TUM-E21-ThinFilms/BigChamber/Relay/Schematics/README.md

# BigChamber-RelayDriver
Electronic schematic of a relay driver, supporting 24 relays @ 10A. The relays are galvanically isolated using optocouplers. The relays are driven using a standard I2C interface (via e.g. Arduino/STM32 BluePill) and shift registers

# Pictures
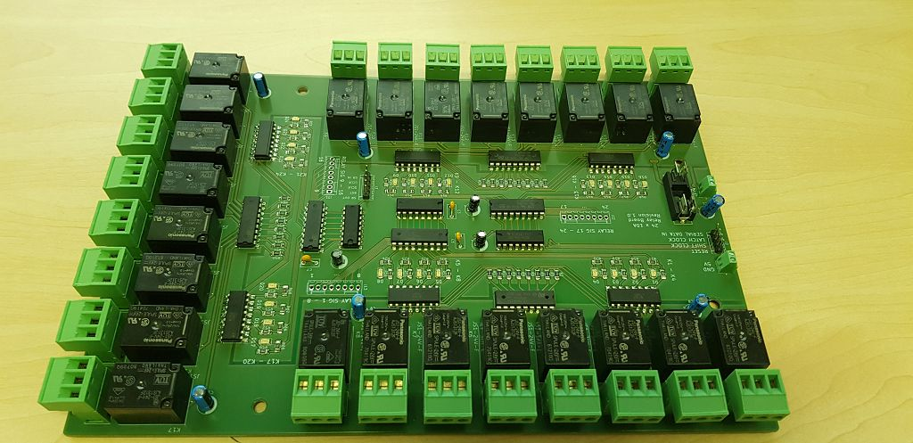
[picture p1: Relay/Schematics/06_Pictures/k-20190725_110336.jpg]
Relay driver overview

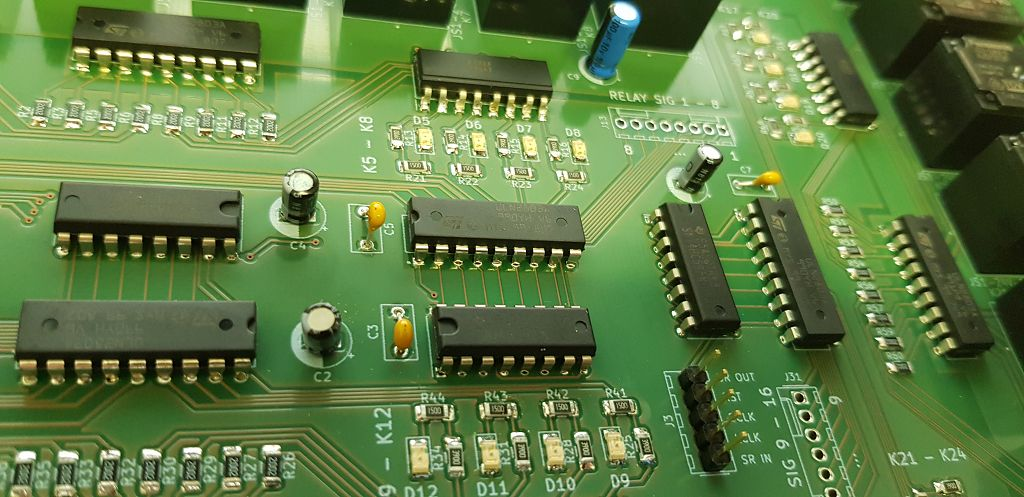
[picture p2: Relay/Schematics/06_Pictures/k-20190725_110252.jpg]
Relay driver closeup view


[pic1]: https://github.com/TUM-E21-ThinFilms/BigChamber/blob/master/Relay/Schematics/06_Pictures/k-20190725_110252.jpg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
[pic2]: https://github.com/TUM-E21-ThinFilms/BigChamber/blob/master/Relay/Schematics/06_Pictures/k-20190725_110336.jpg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
