TUM-E21-ThinFilms/BigChamber/TemperatureSensor/Documentation/TemperatureSensor.odt

Temperature Sensor

Parts

Raspberry Pi (https://go.pimylifeup.com/l8KF94/amazon/raspberrypi)

Micro SD Card

DS18B20 Temperature Sensor (https://go.pimylifeup.com/tYbBFb/amazon/DS18B20)s

4.7 k (https://go.pimylifeup.com/kZ1Fwt/amazon/4k7resistors)Ω (https://go.pimylifeup.com/kZ1Fwt/amazon/4k7resistors) Resistor (https://go.pimylifeup.com/kZ1Fwt/amazon/4k7resistors)

Breadboard (https://go.pimylifeup.com/LSWdzn/amazon/breadboard)

Breadboard Wire (https://go.pimylifeup.com/MxKKAK/amazon/breadboardwire)

Jumper Cables

Protocol

DS18B20 sensors communicates with the “One-Wire” communication protocol, means that only one wire is used to transmit the temperature readings to the micro-controller and two other wires are required for operation :

V CC (Red Wire)

Ground (Black Wire)

Data Wire (Yellow Wire)

A 4.7 kΩ pull-up resistor is placed on the breadboard between the V CC(Red) and, the Data Wire (Yellow).

Then,using jumper cables, the RPi pins are connected as below:

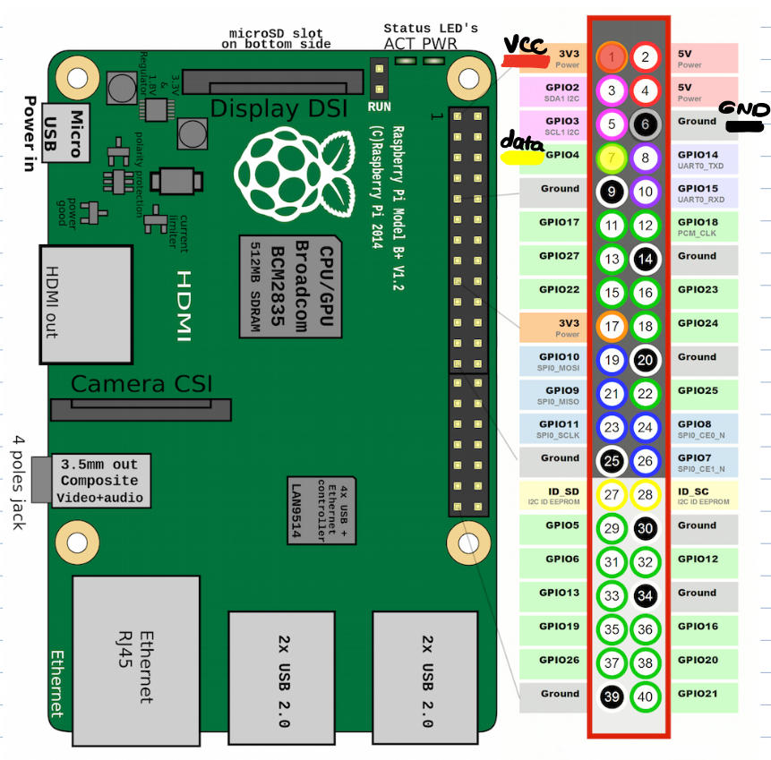
[picture p3: figure]

V CC ==> Pin 1

Ground ==> Pin 6

Data Wire ==> Pin 7

The rest of the sensors can be parallelly connected to the first sensor and the same GPIO pin of Rpi. Because each sensor has a specific wire address to communicate with RPi.

Rpi is already set-up as follows:

User: Pi

Password: raspberryE21

The $ dtoverlay=w1-gpio was added to the last line of the boot config file $ sudo nano /boot/config.txt. After saving and exciting nano, Rpi rebooted with $ sudo reboot. Once the Raspberry Pi has booted back up, mod probe need to run so that correct modules can be loaded:

$ sudo modprobe w1-gpio

$ sudo modprobe w1-therm

So, after connecting the sensors as mentioned, we can move forward to run the codes. Directory for codes are :

/home/pi/Desktop/Documents

Temp-Script.py is the German code file, TemperatureMeasurement.py is the English one and, finally, the MultipleSensors.py contains codes for of all 5 sensors.

In case of any error regarding the wire addresses, it can be solved by opening a terminal and entering this command:

$ ls -l /sys/bus/w1/devices/

We can see the list of wire addresses for all connected sensors. Then the number appeared as 28-XXXX should be replaced in the respective code line of the sensor.

For the sensors we used, the addresses for each are labeled on the cable and you can find it in this table, as well:

Sensor.1 | 28-03049779dae9
Sensor.2 | 28-03049779da5b
Sensor.3 | 28-031197796d7c
Sensor.4 | 28-031197796aa1
Sensor.5 | 28-030297792649
