TUM-E21-ThinFilms/BigChamber/Relay/Schematics/04_Warenkorb/Warenkorb-zweite-Bestellung.pdf

06105/401-234 | http://de.rs-
| online.com

06105/401-100

RS Components GmbH
Hessenring 13b
64546 Mörfelden-Walldorf

Ihr Warenkorb auf de.rs-online.com

Diese Bestellung wurde noch nicht abgeschickt aber automatisch für Ihren nächsten Besuch auf RS Online gespeichert.

Beschreibung | Menge | Preis/ Einheiten

## Warenwert

Panasonic Monostabiles Relais Printrelais,
24Vdc Spule, 1-poliger Wechsler 10 A 6525381
Panasonic
JS1-24V-F
RoHS-Status - Kompatibel

25

### 25 Lieferbar am folgenden

Werktag (Mo-Fr) bei
Bestelleingang werktags bis 22 Uhr.

1,28 €
Stück

32,00 €

NPN Darlington-Paar ULN2803A 50 V 500 mA HFE:1000, PDIP 18-Pin Gemeinsamer Impulsgeber
7141167
STMicroelectronics
ULN2803A
RoHS-Status - Kompatibel

5

### 5 Lieferbar am folgenden

Werktag (Mo-Fr) bei
Bestelleingang werktags bis 22 Uhr.

1,038 €
Stück (In
einer VPE à 5)

5,19 €

Lite-On 4 Optokoppler, 50 mA DC Input Transistor Output, 5 kV eff 50 % SMD, PDIP 16-Pin
6912246
Lite-On
LTV-847S
RoHS-Status - Kompatibel

6

6 Voraussichtlich ab 14.10.2019 verfügbar.

0,675 €
Stück (In
einer VPE à 2)

4,05 €

KEMET, Goldmax 300 THT MLCC, Vielschicht Keramikkondensator X7R, 100nF ±10% / 50Vdc, 125°C, Gehäuse Radial
5381310
KEMET
C320C104K5R5TA
RoHS-Status - Kompatibel

5

### 5 Lieferbar am folgenden

Werktag (Mo-Fr) bei
Bestelleingang werktags bis 22 Uhr.

0,186 €
Stück (In
einer VPE à 5)

0,93 €

Vishay 038 RSU, THT Alu Kondensator, Elko 100μF ±20%, 10Vdc, Ø 5mm, –40 → +85 °C 6841872
Vishay
MAL203854101E3
RoHS-Status - Kompatibel

5

### 5 lieferbar innerhalb von 1

Werktag(en) (Mo-Fr).

0,048 €
Stück (In
einer VPE à 5)

0,24 €

Kingbright 1206 SMD LED grün 2,2 V, 120° rechteckige Linse 3216 / 1206
4663908
Kingbright
KP-3216SGC
RoHS-Status - Kompatibel

40

### 40 Lieferbar am folgenden

Werktag (Mo-Fr) bei
Bestelleingang werktags bis 22 Uhr.

0,167 €
Stück (In einer
VPE à 40)

6,68 €

06105/401-234 | http://de.rs-
| online.com

06105/401-100

Nichicon SR, THT Alu Kondensator, Elko 1μF ±20%, 50Vdc, Ø 4mm, –40 → +85 °C 4759009
Nichicon
USR1H010MDD
RoHS-Status - Kompatibel

5

### 5 Lieferbar am folgenden

Werktag (Mo-Fr) bei
Bestelleingang werktags bis 22 Uhr.

0,148 €
Stück (In
einer VPE à 5)

0,74 €

Molex KK 254 Female 2.54mm, 8-polig / 1-reihig Gerade, Kabelmontage
6795417
Molex
22-01-3087
RoHS-Status - Kompatibel

10

### 10 Lieferbar am folgenden

Werktag (Mo-Fr) bei
Bestelleingang werktags bis 22 Uhr.

0,275 €
Stück (In einer
VPE à 10)

2,75 €

Molex KK 254 Leiterplatten-Stiftleiste gerade, 8-polig / 1-reihig, Raster 2.54mm, Lötanschluss, 4A
6795606
Molex
22-23-2081
RoHS-Status - Kompatibel

10

### 10 lieferbar innerhalb von 1

Werktag(en) (Mo-Fr).

0,392 €
Stück (In einer
VPE à 10)

3,92 €

Molex KK 254 Female 2.54mm, 4-polig / 1-reihig Gerade, Kabelmontage
6795388
Molex
22-01-3047
RoHS-Status - Kompatibel

10

### 10 Lieferbar am folgenden

Werktag (Mo-Fr) bei
Bestelleingang werktags bis 22 Uhr.

0,134 €
Stück (In einer
VPE à 10)

1,34 €

Molex KK 254 Leiterplatten-Stiftleiste gerade, 4-polig / 1-reihig, Raster 2.54mm, Lötanschluss, 4A
6795596
Molex
22-23-2041
RoHS-Status - Kompatibel

10

### 10 Lieferbar am folgenden

Werktag (Mo-Fr) bei
Bestelleingang werktags bis 22 Uhr.

0,233 €
Stück (In einer
VPE à 10)

2,33 €

Molex KK 254 Female 2.54mm, 5-polig / 1-reihig Gerade, Kabelmontage
6795385
Molex
22-01-3057
RoHS-Status - Kompatibel

10

### 10 Lieferbar am folgenden

Werktag (Mo-Fr) bei
Bestelleingang werktags bis 22 Uhr.

0,237 €
Stück (In einer
VPE à 10)

2,37 €

Molex KK 254 Leiterplatten-Stiftleiste gerade, 5-polig / 1-reihig, Raster 2.54mm, Lötanschluss, 4A
6795599
Molex
22-23-2051
RoHS-Status - Kompatibel

10

### 10 Lieferbar am folgenden

Werktag (Mo-Fr) bei
Bestelleingang werktags bis 22 Uhr.

0,245 €
Stück (In einer
VPE à 10)

2,45 €

Molex KK 254 Female Crimp-Anschlussklemmenkontakt, Crimpmontage, für KK 254-Steckverbindergehäuse 7205952
Molex
39-00-0372
RoHS-Status - Kompatibel

100
100 Lieferbar am folgenden Werktag (Mo-Fr) bei
Bestelleingang werktags bis 22 Uhr.

0,025 €
Stück (In einer
VPE à 100)

2,50 €

Versandart

Versandart | Standard
Warenwert insgesamt | 67,49 €
Lieferung | Kostenfrei
MwSt | 12,82 €
Gesamtbetrag | 80,31 €
