TUM-E21-ThinFilms/BigChamber/FrontInterface/WarenKorb.pdf

069/5800 14 234 | http://de.rs-
| online.com

069/5800 14 100

RS Components GmbH
Hessenring 13b
60327 Frankfurt am Main

Ihr Warenkorb auf de.rs-online.com

Diese Bestellung wurde noch nicht abgeschickt aber automatisch für Ihren nächsten Besuch auf RS Online gespeichert.

Beschreibung | Menge | Preis/ Einheiten

## Warenwert

Kat.3 RJ45-Steckverbinder, Ungeschirmt,
Buchse 8P8C-polig, Rechtwinklig 1-Port 2400935
Molex
95501-2881
RoHS-Status - Kompatibel

6

### 6 Lieferbar am folgenden

Werktag (Mo-Fr) bei
Bestelleingang werktags bis 22 Uhr.

0,62 €
Stück

3,72 €

AVX SMD MLCC, Vielschicht
Keramikkondensator X7R, 100nF ±10% / 50Vdc, 125°C, Gehäuse 0805 (2012M) 4646688
AVX
08055C104KAT2A
RoHS-Status - Kompatibel

50

### 50 Lieferbar am folgenden

Werktag (Mo-Fr) bei
Bestelleingang werktags bis 22 Uhr.

0,011 €
Stück (In einer
VPE à 50)

0,55 €

Phoenix Contact COMBICON MPT Leiterplattenklemmleiste / Buchse, 2-polig / 1-reihig, Raster 2.54mm, Länge 5,5mm 2204260
Phoenix Contact
1725656
RoHS-Status - Nicht konform

5

### 5 Lieferbar am folgenden

Werktag (Mo-Fr) bei
Bestelleingang werktags bis 22 Uhr.

1,436 €
Stück (In
einer VPE à 5)

7,18 €

TE Connectivity CRG SMD
Dickschichtwiderstand, 120Ω ±1%, 1206 2232136
TE Connectivity
CRG1206F120R
RoHS-Status - Kompatibel

50

### 50 Lieferbar am folgenden

Werktag (Mo-Fr) bei
Bestelleingang werktags bis 22 Uhr.

0,058 €
Stück (In einer
VPE à 50)

2,90 €

Würth WR-BHD Leiterplatten-Stiftleiste Stecker gerade, 8-polig / 2-reihig, Raster 2.54mm, Lötanschluss, 3A
8236434
Wurth Elektronik
61200821621
RoHS-Status - Kompatibel

2

### 2 Lieferbar am folgenden

Werktag (Mo-Fr) bei
Bestelleingang werktags bis 22 Uhr.

0,93 €
Stück

1,86 €

KEMET, C SMD MLCC, Vielschicht Keramikkondensator C0G, 22pF ±5% / 50Vdc, 125°C, Gehäuse 0805 (2012M) 2644258
KEMET
C0805C220J5GACTU
RoHS-Status - Kompatibel

25

### 25 Lieferbar am folgenden

Werktag (Mo-Fr) bei
Bestelleingang werktags bis 22 Uhr.

0,069 €
Stück (In einer
VPE à 25)

1,725 €

KEMET, C SMD MLCC, Vielschicht Keramikkondensator X5R, 10μF ±10% / 16Vdc, Gehäuse 0805 (2012M) 6911161
KEMET
C0805C106K4PACTU
RoHS-Status - Kompatibel

10

### 10 Lieferbar am folgenden

Werktag (Mo-Fr) bei
Bestelleingang werktags bis 22 Uhr.

0,127 €
Stück (In einer
VPE à 10)

1,27 €

Vishay 593D SMD Tantal Elko, Kondensator, 22μF ±10%, 16V dc, +125°C, Gehäuse 3528-21
6844525
Vishay
593D226X9016B2TE3
RoHS-Status - Kompatibel

10

### 10 lieferbar innerhalb von 1

Werktag(en) (Mo-Fr).

0,156 €
Stück (In einer
VPE à 10)

1,56 €

Vishay CRCW SMD Dickschichtwiderstand, 10kΩ ±1%, 0805
6790816
Vishay
CRCW080510K0FKEA
RoHS-Status - Kompatibel

50

### 50 Lieferbar am folgenden

Werktag (Mo-Fr) bei
Bestelleingang werktags bis 22 Uhr.

0,034 €
Stück (In einer
VPE à 50)

1,70 €

TE Connectivity CRG SMD
Dickschichtwiderstand, 470Ω ±1% 0,125W, 0805
2230376
TE Connectivity
CRG0805F470R
RoHS-Status - Kompatibel

50

### 50 Lieferbar am folgenden

Werktag (Mo-Fr) bei
Bestelleingang werktags bis 22 Uhr.

0,021 €
Stück (In einer
VPE à 50)

1,05 €

Vishay CRCW SMD Dickschichtwiderstand, 51kΩ ±1%, 0805
6791525
Vishay
CRCW080551K0FKEA
RoHS-Status - Kompatibel

50

### 50 Lieferbar am folgenden

Werktag (Mo-Fr) bei
Bestelleingang werktags bis 22 Uhr.

0,029 €
Stück (In einer
VPE à 50)

1,45 €

Vishay CRCW SMD Dickschichtwiderstand, 43kΩ ±1%, 0805
6791402
Vishay
CRCW080543K0FKEA
RoHS-Status - Kompatibel

50

### 50 Lieferbar am folgenden

Werktag (Mo-Fr) bei
Bestelleingang werktags bis 22 Uhr.

0,057 €
Stück (In einer
VPE à 50)

2,85 €

Vishay CRCW SMD Dickschichtwiderstand, 8.2kΩ ±1%, 0805
6791727
Vishay
CRCW08058K20FKEA
RoHS-Status - Kompatibel

50

### 50 Lieferbar am folgenden

Werktag (Mo-Fr) bei
Bestelleingang werktags bis 22 Uhr.

0,038 €
Stück (In einer
VPE à 50)

1,90 €

Murata Ferrite Bead 0805 (2012M), Serie BLM21RK, 2 x 1.25 x 0.85mm
7241551
Murata
BLM21RK102SN1D
RoHS-Status - Kompatibel

25

### 25 lieferbar innerhalb von 1

Werktag(en) (Mo-Fr).

0,079 €
Stück (In einer
VPE à 25)

1,975 €

RS PRO Drosselspule, ±22 μH, 20MHz 800mA, 16 Gehäuse
1245570
RS PRO
NPI16W220MTRF
RoHS-Status - Kompatibel

10

### 10 lieferbar innerhalb von 1

Werktag(en) (Mo-Fr).

0,24 €
Stück (In einer
VPE à 10)

2,40 €

Quarz FOXSLF/080-20 8MHz, ±30ppm, HC-49-SLF 2-Pin, 11.35 x 4.65 x 3.6mm 5476216
Fox Electronics
FOXSLF/080-20
RoHS-Status - Kompatibel

5

### 5 Lieferbar am folgenden

Werktag (Mo-Fr) bei
Bestelleingang werktags bis 22 Uhr.

0,294 €
Stück (In
einer VPE à 5)

1,47 €

TVS-Diode Bi-Directional P6SMB33CA R5, 45.7V 600W, DO-214AA (SMB) 2-Pin 6872980
Taiwan Semiconductor
P6SMB33CA R5
RoHS-Status - Kompatibel

20

### 20 lieferbar innerhalb von 1

Werktag(en) (Mo-Fr).

0,108 €
Stück (In einer
VPE à 20)

2,16 €

S1B R2 Schaltdiode Switching, 100V / 1.1A 1.8μs, DO-214AC (SMA) 2-Pin
7485149
Taiwan Semiconductor
S1B R2
RoHS-Status - Kompatibel

50

### 50 lieferbar innerhalb von 1

Werktag(en) (Mo-Fr).

0,067 €
Stück (In einer
VPE à 50)

3,35 €

1N4148WSF-7 Schaltdiode Switching, 100V / 250mA 4ns, SOD-323F 2-Pin 1335600
DiodesZetex
1N4148WSF-7
RoHS-Status - Kompatibel

100
100 Lieferbar am folgenden Werktag (Mo-Fr) bei
Bestelleingang werktags bis 22 Uhr.

0,054 €
Stück (In einer
VPE à 100)

5,40 €

MBRS140T3G Schottky Diode, 40V / 1A, DO-214AA (SMB) 2-Pin
5452074
ON Semiconductor
MBRS140T3G
RoHS-Status - Kompatibel

2

### 2 Lieferbar am folgenden

Werktag (Mo-Fr) bei
Bestelleingang werktags bis 22 Uhr.

0,34 €
Stück

0,68 €

TVS-Diode Bi-Directional P6SMB15CA, 21.2V 600W, DO-214AA (SMB) 2-Pin
7645477
Littelfuse
P6SMB15CA
RoHS-Status - Kompatibel

10

### 10 Lieferbar am folgenden

Werktag (Mo-Fr) bei
Bestelleingang werktags bis 22 Uhr.

0,31 €
Stück (In einer
VPE à 10)

3,10 €

CANbus Transceiver 1Mbit/s Gemäß IEC 61000-4-2, Standby, SOIC 8-Pin 7990216
Microchip
MCP2561-E/SN
RoHS-Status - Kompatibel

10

### 10 Lieferbar am folgenden

Werktag (Mo-Fr) bei
Bestelleingang werktags bis 22 Uhr.

0,659 €
Stück (In einer
VPE à 10)

6,59 €

Microchip MCP16301T-I/CHY DC/DC-Wandler, 550 kHz / 600mA, SOT-23 6-Pin, Einstellbar
7709476
Microchip
MCP16301T-I/CHY
RoHS-Status - Kompatibel

4

### 4 Lieferbar am folgenden

Werktag (Mo-Fr) bei
Bestelleingang werktags bis 22 Uhr.

0,915 €
Stück (In
einer VPE à 4)

3,66 €

Leitungstransceiver ADM3251EARWZ, EIA/ TIA-232-E/ RS-232 460kbit/s, 5 V, SOIC 20-Pin
7097972
Analog Devices
ADM3251EARWZ
RoHS-Status - Kompatibel

2

### 2 Lieferbar am folgenden

Werktag (Mo-Fr) bei
Bestelleingang werktags bis 22 Uhr.

5,88 €
Stück

11,76 €

Versandart

Versandart | Standard
Warenwert insgesamt | 72,26 €
Lieferung | Kostenfrei
MwSt | 13,73 €
Gesamtbetrag | 85,99 €
