TUM-E21-ThinFilms/BigChamber/FrontInterface/guns.png

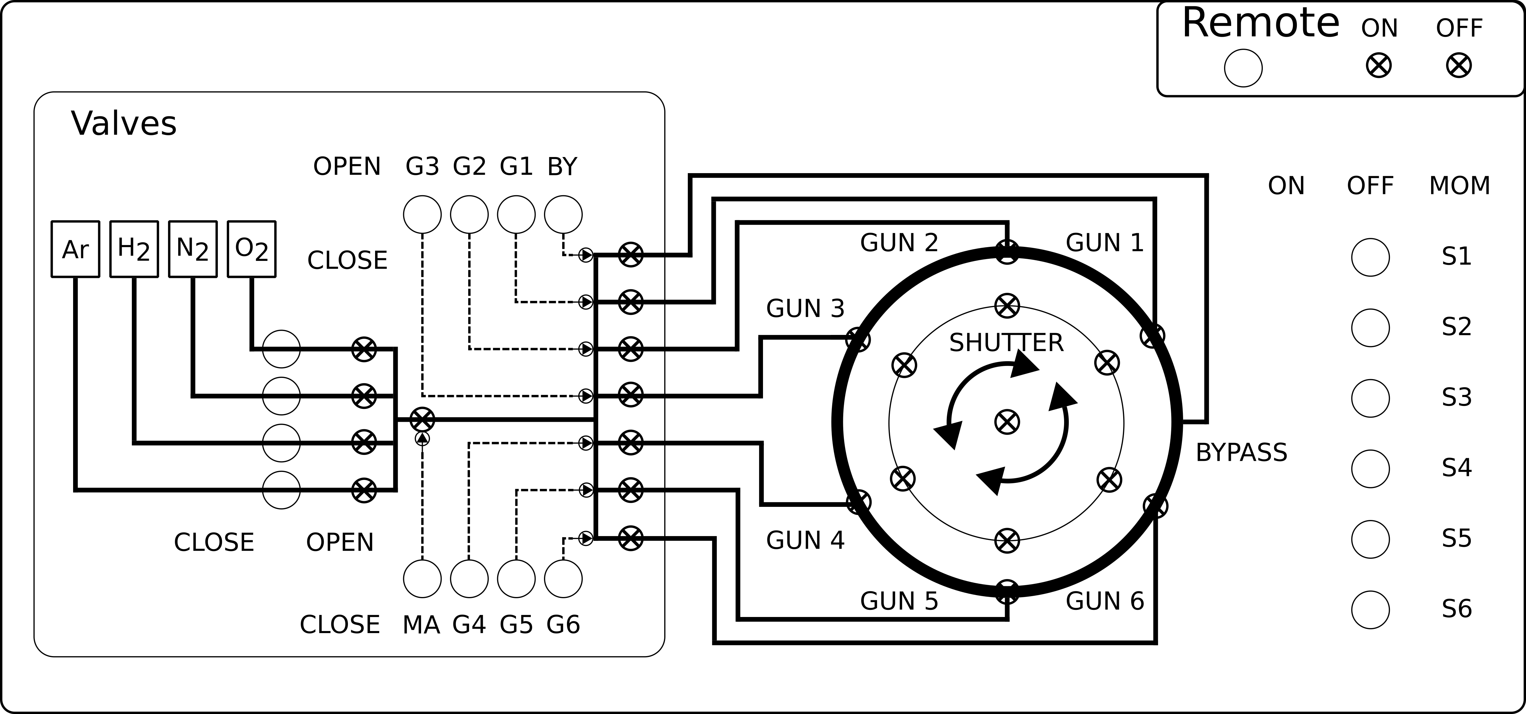
FrontInterface/guns.png
