TUM-E21-ThinFilms/BigChamber/FrontInterface/guns.svg.2018_10_05_22_57_22.0.png

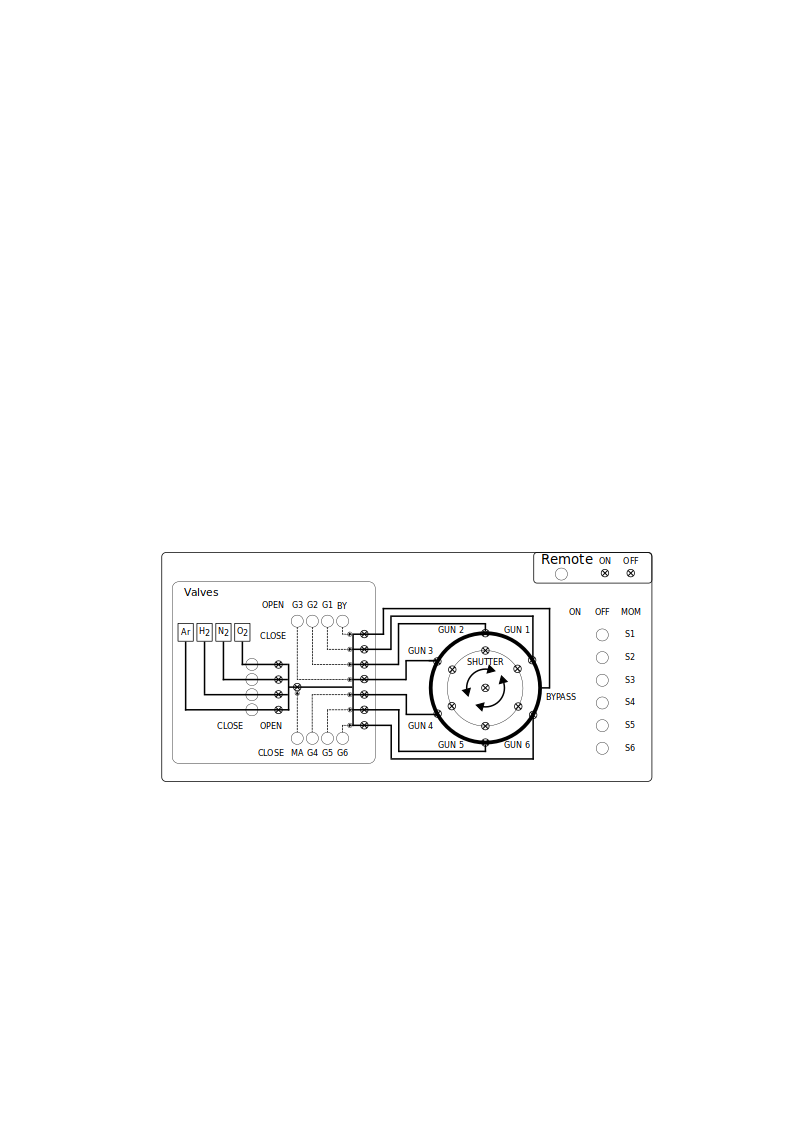
FrontInterface/guns.svg.2018_10_05_22_57_22.0.png
