TUM-E21-ThinFilms/BigChamber/Motor/Schematics/03_Frontpanel/g851-6.png

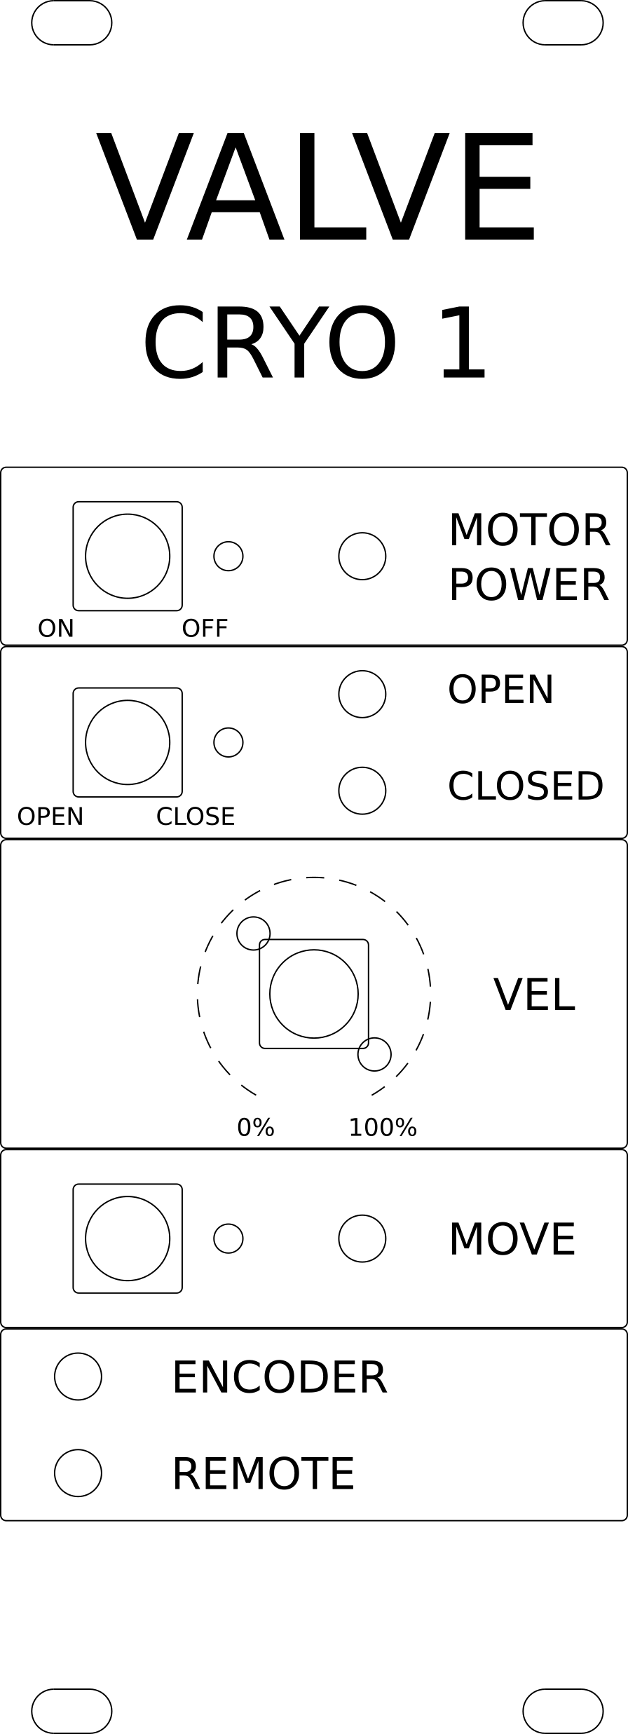
Motor/Schematics/03_Frontpanel/g851-6.png
