TUM-E21-ThinFilms/BigChamber/Motor/Schematics/03_Frontpanel/Zeichnung.svg.png

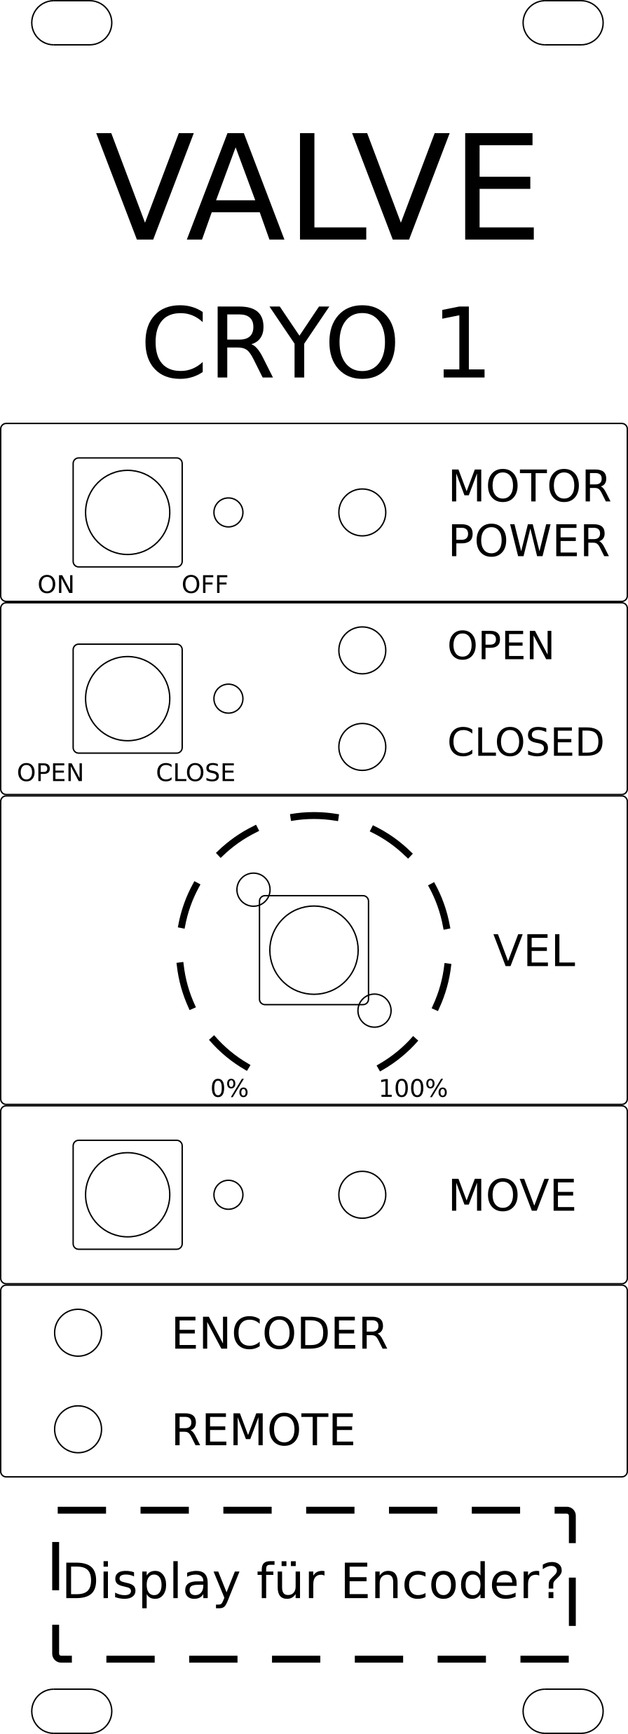
Motor/Schematics/03_Frontpanel/Zeichnung.svg.png
