TUM-E21-ThinFilms/BigChamber/Relay/Schematics/04_Warenkorb/RS_order-Mon May 13 19_48_28 BST 2019.pdf

06105/401-234 | http://de.rs-
| online.com

06105/401-100

RS Components GmbH
Hessenring 13b
64546 Mörfelden-Walldorf

Ihr Warenkorb auf de.rs-online.com

Diese Bestellung wurde noch nicht abgeschickt aber automatisch für Ihren nächsten Besuch auf RS Online gespeichert.

Beschreibung | Menge | Preis/ Einheiten

## Warenwert

NPN Darlington-Paar ULN2803A 50 V 500
mA HFE:1000, PDIP 18-Pin
7141167
STMicroelectronics
ULN2803A
RoHS-Status - Kompatibel

5

### 5 Lieferbar am folgenden

Werktag (Mo-Fr) bei
Bestelleingang werktags bis 22 Uhr.

1,038 €
Stück (In
einer VPE à 5)

5,19 €

Isocom Optokoppler, 60 mA DC Input Transistor Output, 5,3 kV eff PCB-Montage, PDIP 6-Pin
0597289
Isocom
4N25
RoHS-Status - Kompatibel

2

### 2 Lieferbar am folgenden

Werktag (Mo-Fr) bei
Bestelleingang werktags bis 22 Uhr.

0,49 €
Stück

0,98 €

SN74HC595N 8-Bit Schieberegister HC Seriell - Seriell/Parallel Uni-Directional 2 → 6 V 16-Pin PDIP
1000763
Texas Instruments
SN74HC595N
RoHS-Status - Kompatibel

25

### 25 Lieferbar am folgenden

Werktag (Mo-Fr) bei
Bestelleingang werktags bis 22 Uhr.

0,477 €
Stück (In einer
Stange von 25)

11,925 €

SN74HC590ANE4 8-Bit Zähler HC Binär Aufwärtszähler Uni-Directional 2 → 6 V 16-Pin PDIP
7092523
Texas Instruments
SN74HC590ANE4
RoHS-Status - Nicht zutreffend

5

### 5 lieferbar innerhalb von 1

Werktag(en) (Mo-Fr).

0,634 €
Stück (In
einer VPE à 5)

3,17 €

Vishay 199D Durchsteck Tantal Elko, Kondensator, 1μF ±10%, 50Vdc, +85°C, Gehäuse B
8309964
Vishay
199D105X9050B1V1E3
RoHS-Status - Kompatibel

4

### 4 lieferbar innerhalb von 1

Werktag(en) (Mo-Fr).

1,09 €
Stück

4,36 €

Cooper Bussmann 6 x 32mm
Sicherungsblock, Steckmontage, 25A 8527216
Cooper Bussmann
S-8001-1-R
RoHS-Status - Kompatibel

1

### 1 lieferbar innerhalb von 1

Werktag(en) (Mo-Fr).

1,03 €
Stück

1,03 €

Kingbright THT LED grün 2 V, 60° Rund-Linse 5 mm / T-1 3/4
2286004
Kingbright
L-53GD
RoHS-Status - Kompatibel

25

### 25 Lieferbar am folgenden

Werktag (Mo-Fr) bei
Bestelleingang werktags bis 22 Uhr.

0,20 €
Stück (In
einer VPE à 5)

5,00 €

KEMET, Goldmax 300 THT MLCC, Vielschicht Keramikkondensator X7R, 100nF ±10% / 50Vdc, 125°C, Gehäuse Radial
5381310
KEMET
C320C104K5R5TA
RoHS-Status - Kompatibel

5

### 5 Lieferbar am folgenden

Werktag (Mo-Fr) bei
Bestelleingang werktags bis 22 Uhr.

0,186 €
Stück (In
einer VPE à 5)

0,93 €

Vishay 038 RSU, THT Alu Kondensator, Elko 100μF ±20%, 10Vdc, Ø 5mm, –40 → +85 °C 6841872
Vishay
MAL203854101E3
RoHS-Status - Kompatibel

10

### 10 lieferbar innerhalb von 1

Werktag(en) (Mo-Fr).

0,106 €
Stück (In
einer VPE à 5)

1,06 €

Würth 311 Stiftleiste / Stecker, 2-polig / 1-reihig, Raster 5.08mm, Länge 12.16mm, Lötanschluss
8267377
Wurth Elektronik
691311500102
RoHS-Status - Kompatibel

100
100 Lieferbar am folgenden Werktag (Mo-Fr) bei
Bestelleingang werktags bis 22 Uhr.

0,29 €
Stück

29,00 €

Phoenix Contact COMBICON MPT Leiterplattenklemmleiste / Buchse, 2-polig / 1-reihig, Raster 2.54mm, Länge 5,5mm 2204260
Phoenix Contact
1725656
RoHS-Status - Nicht konform

10

### 10 Lieferbar am folgenden

Werktag (Mo-Fr) bei
Bestelleingang werktags bis 22 Uhr.

0,71 €
Stück (In
einer VPE à 5)

7,10 €

Würth WR-PHD Stiftleiste gerade, 4-polig / 1-reihig, Raster 2.54mm, Lötanschluss, 3A 8281594
Wurth Elektronik
61300411121
RoHS-Status - Kompatibel

5

### 5 Lieferbar am folgenden

Werktag (Mo-Fr) bei
Bestelleingang werktags bis 22 Uhr.

0,17 €
Stück (In
einer VPE à 5)

0,85 €

Würth WR-PHD Stiftleiste gerade, 5-polig / 1-reihig, Raster 2.54mm, Lötanschluss, 3A 8281597
Wurth Elektronik
61300511121
RoHS-Status - Kompatibel

5

### 5 Lieferbar am folgenden

Werktag (Mo-Fr) bei
Bestelleingang werktags bis 22 Uhr.

0,23 €
Stück (In
einer VPE à 5)

1,15 €

Amphenol Socapex T821 Leiterplatten-Stiftleiste gerade, 16-polig / 2-reihig, Raster 2.54mm, Lötanschluss, 3A
8323500
Amphenol
T821116A1S100CEU
RoHS-Status - Kompatibel

1

### 1 Lieferbar am folgenden

Werktag (Mo-Fr) bei
Bestelleingang werktags bis 22 Uhr.

0,36 €
Stück

0,36 €

Panasonic Printrelais Monostabiles Relais, 24Vdc Spule, 1-poliger Wechsler 6502518
Panasonic
JS1-24V-F
RoHS-Status - Kompatibel

24

### 24 Lieferbar am folgenden

Werktag (Mo-Fr) bei
Bestelleingang werktags bis 22 Uhr.

7,35 €
1 Beutel
mit 5 Stück

176,40 €

Versandart

Versandart | Standard
Warenwert insgesamt | 248,50 €
Lieferung | Kostenfrei
MwSt | 47,22 €
Gesamtbetrag | 295,72 €
