TUM-E21-ThinFilms/BigChamber/Motor/Schematics/05_Schematics/Motor.pdf

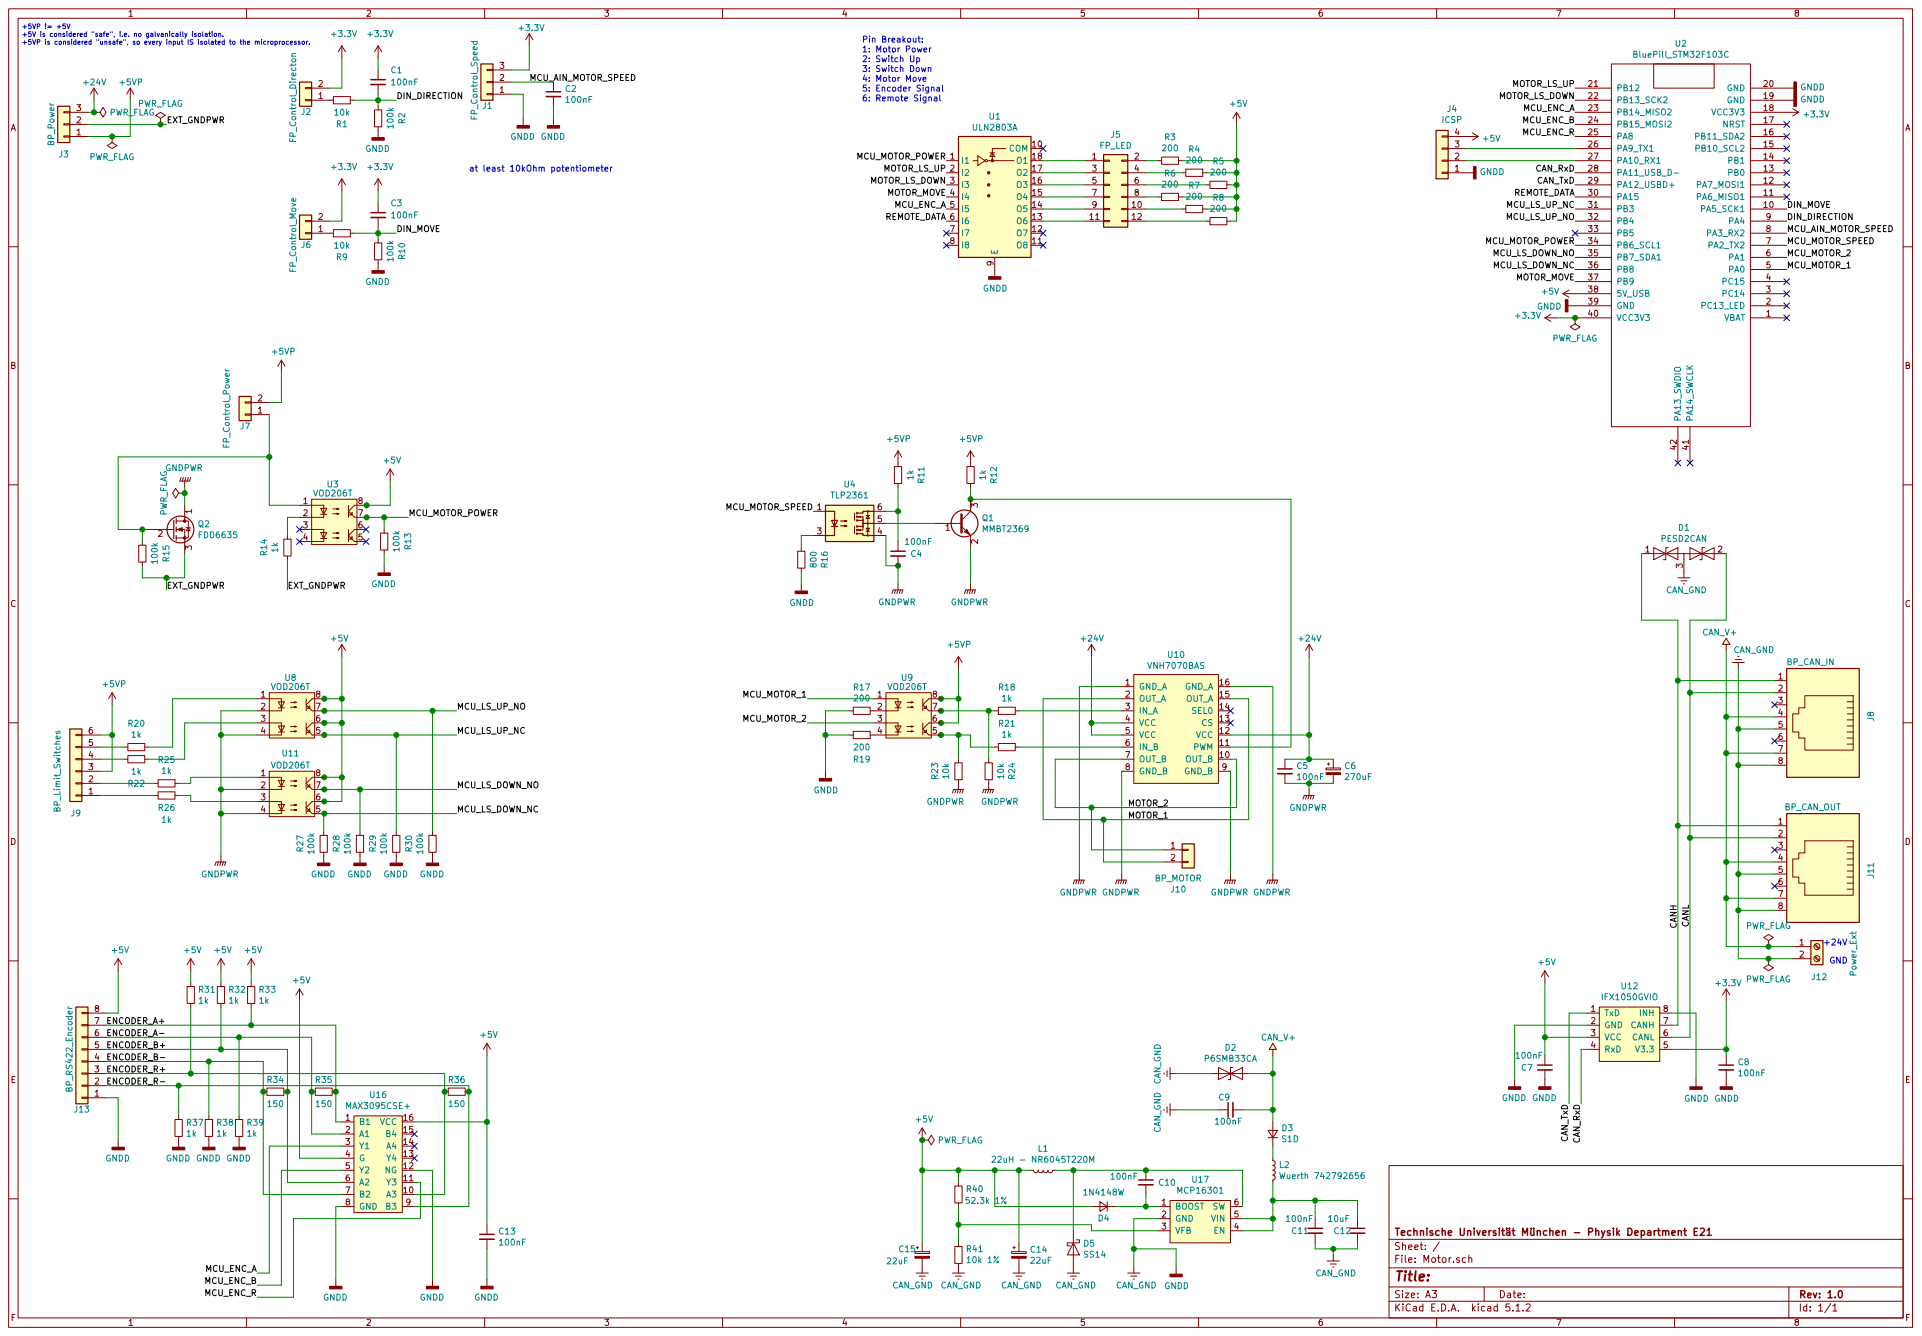
[picture p8: page 1]

Pin Breakout: 1: Motor Power 2: Switch Up

3 4

Id: 1/1 Title: File: Motor.sch Sheet: / Technische Universität München - Physik Department E21
