TUM-E21-ThinFilms/BigChamber/Relay/Schematics/05_Schematics/relay_controller.pdf

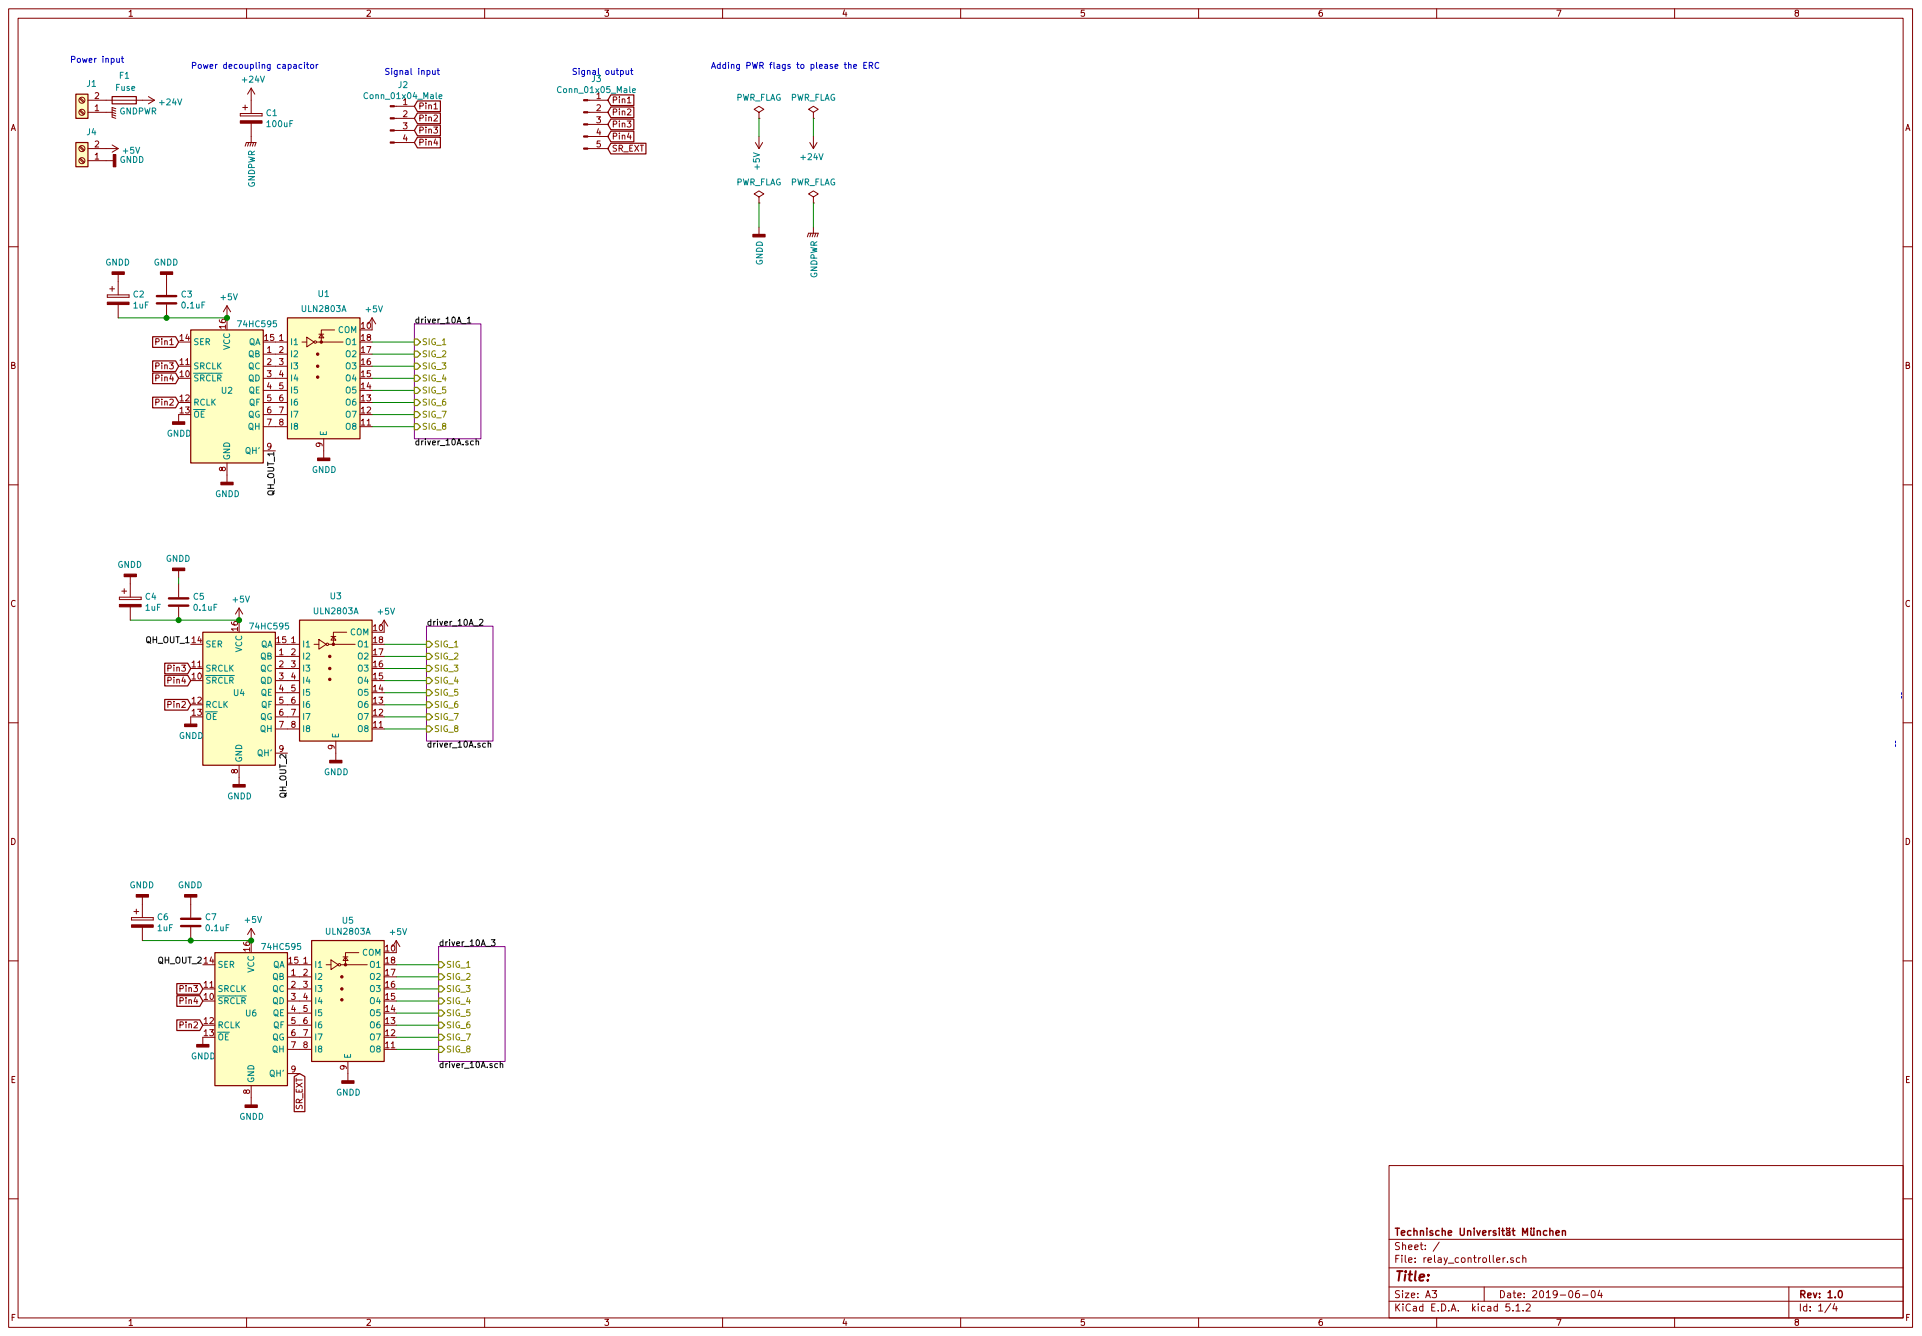
[picture p9: page 1]

Power decoupling capacitor Power input

Adding PWR flags to please the ERC

File: relay_controller.sch Sheet: / Technische Universität München

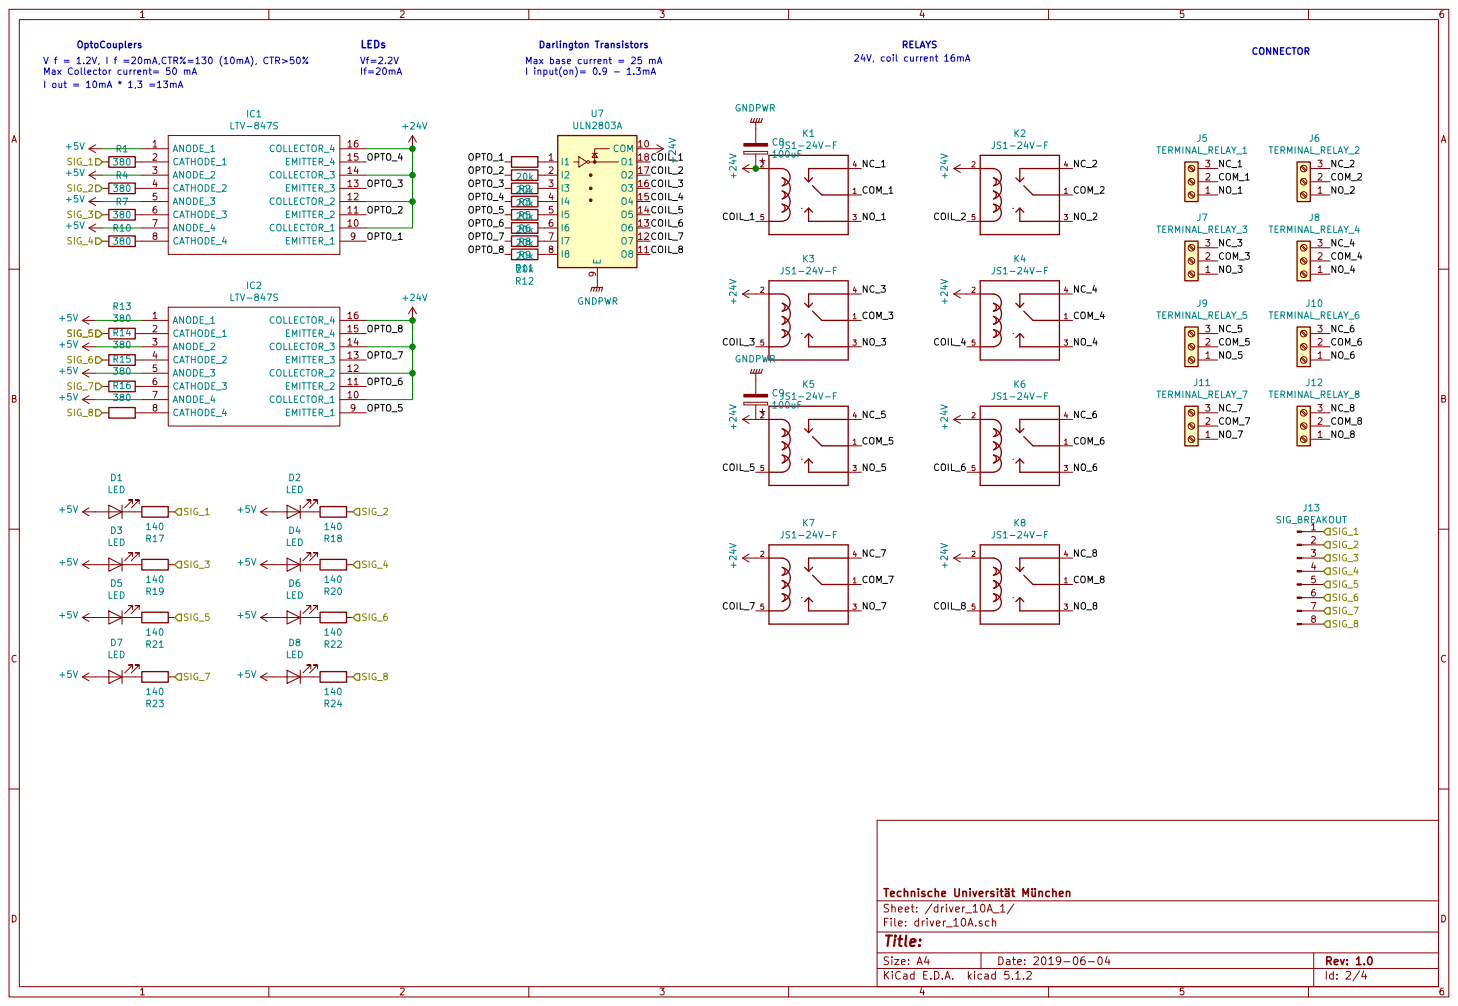
[picture p10: page 2]

Sheet: /driver_10A_1/ Technische Universität München

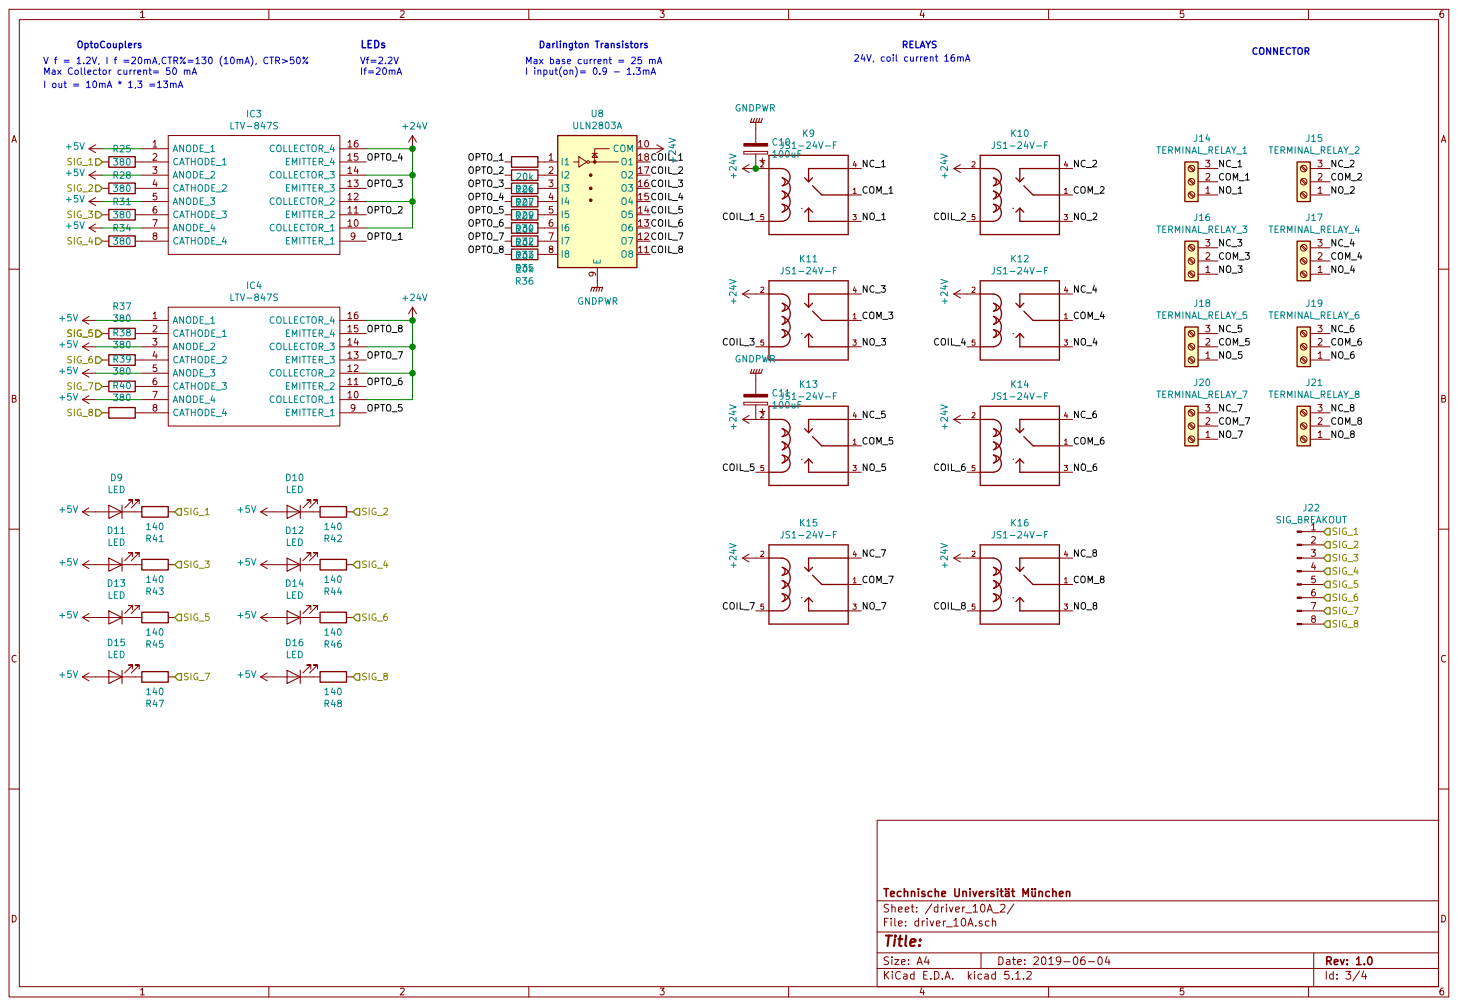
[picture p11: page 3]

Sheet: /driver_10A_2/ Technische Universität München

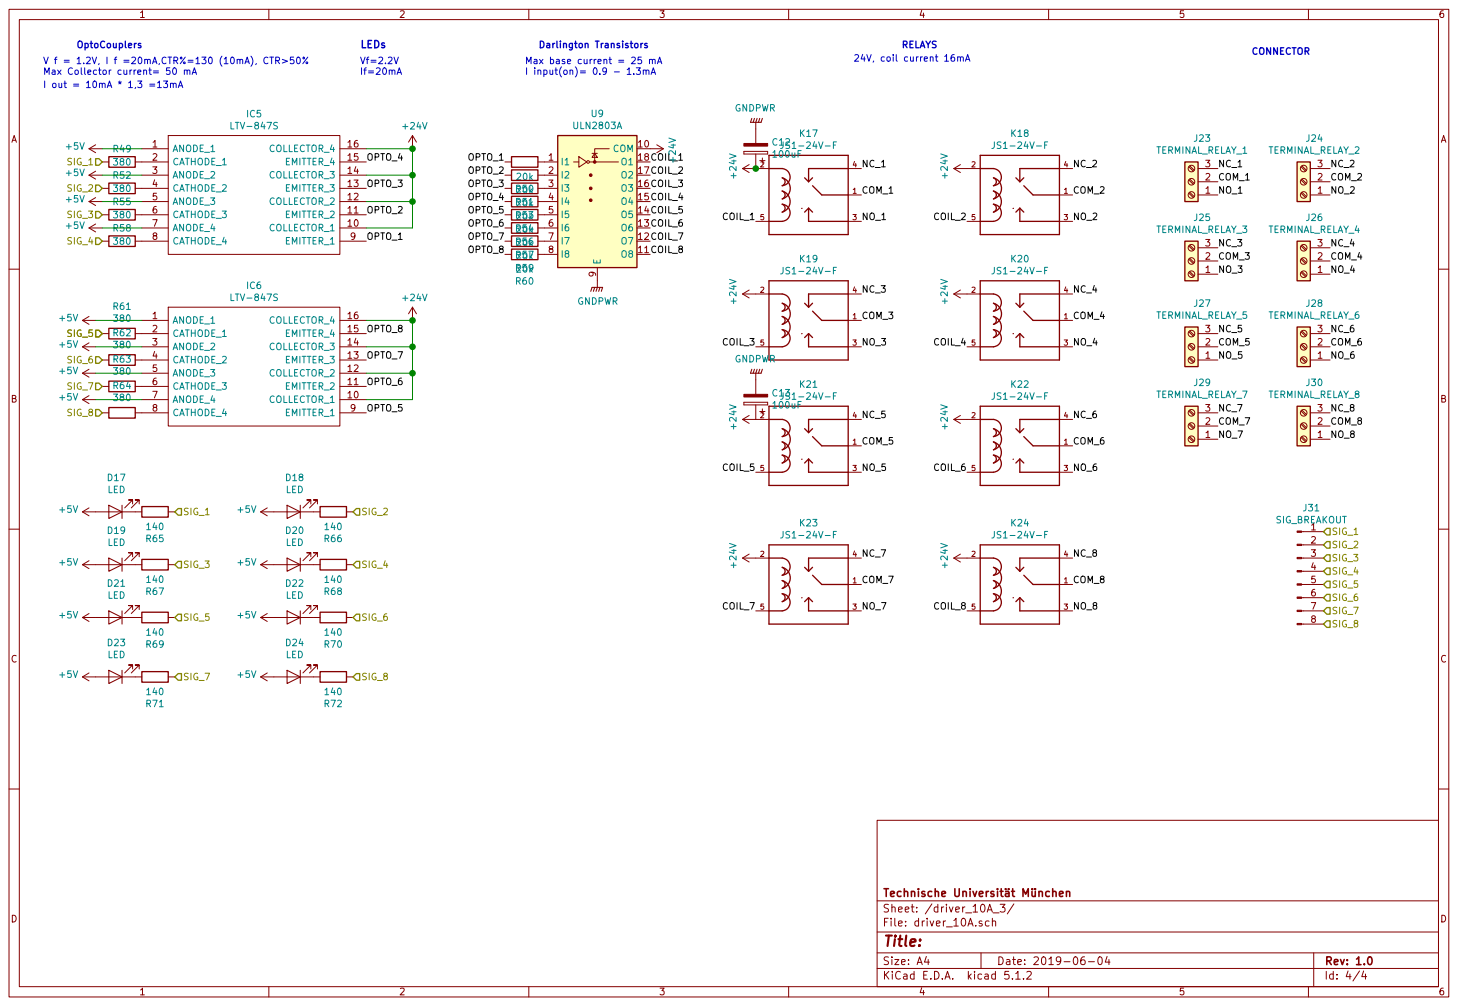
[picture p12: page 4]

Sheet: /driver_10A_3/ Technische Universität München
