TUM-E21-ThinFilms/BigChamber/Relay/Schematics/05_Schematics/Relay_Controller2-F_SilkS.pdf

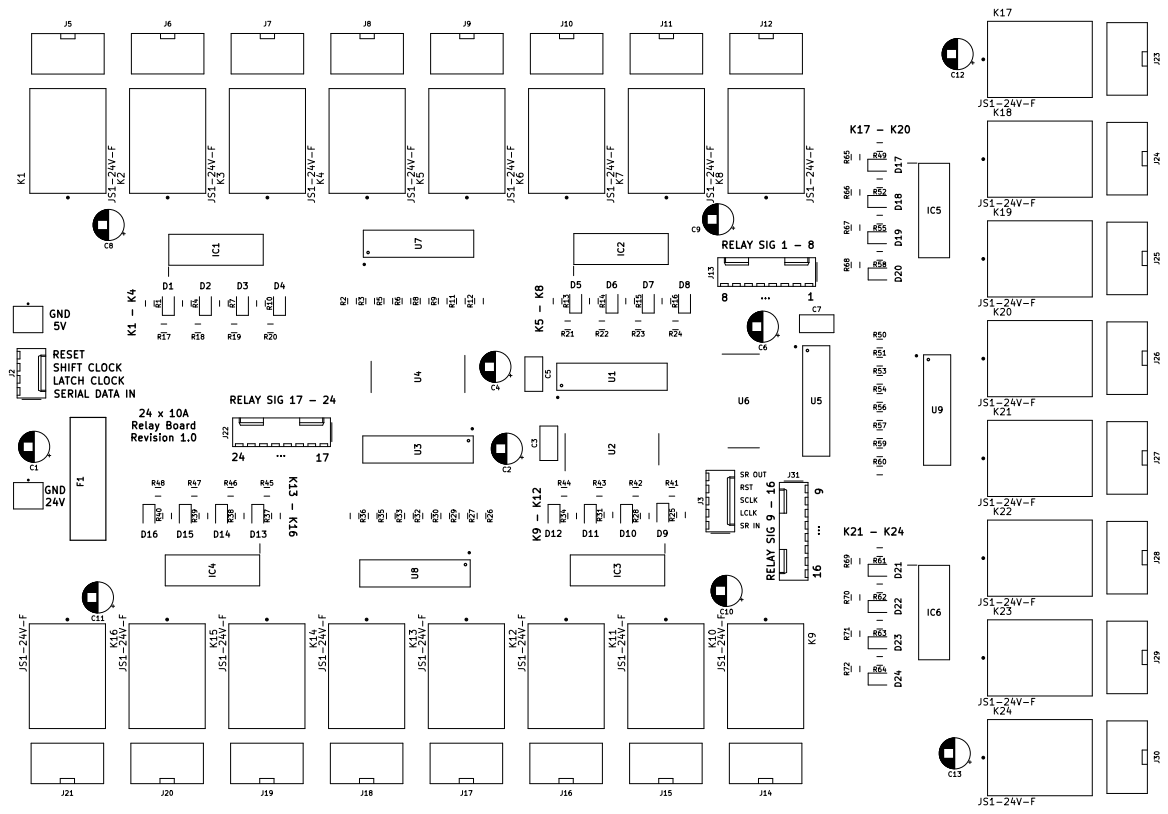
[picture p13: page 1]

SERIAL DATA IN GND

RST SCLK RESET SHIFT CLOCK
