TUM-E21-ThinFilms/BigChamber/Motor/Schematics/05_Schematics/Motor-B_Cu.pdf

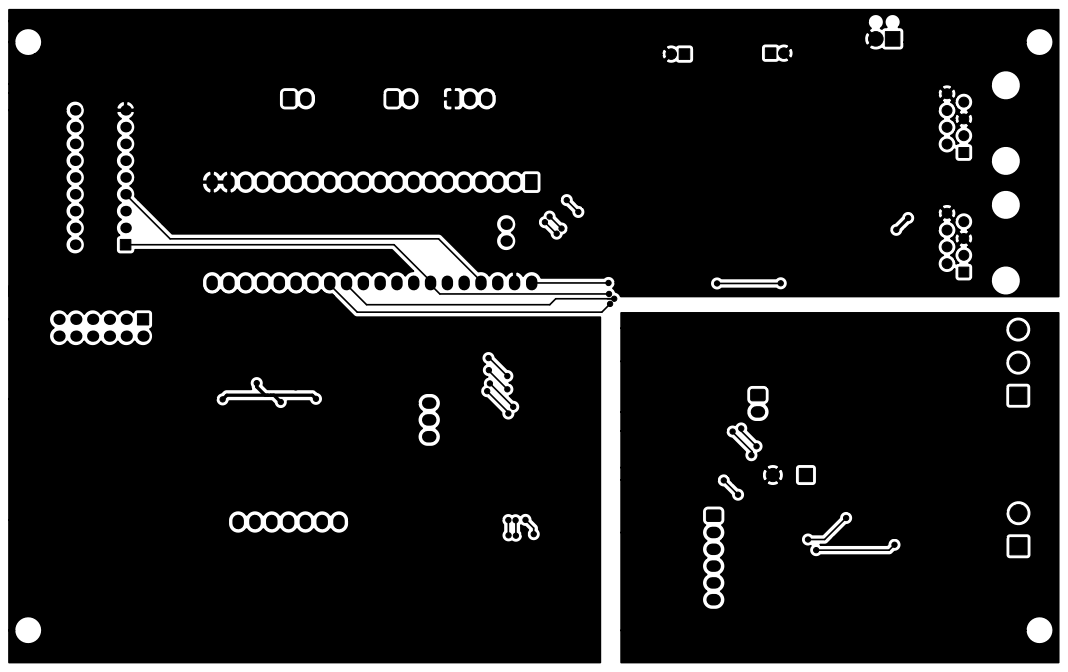
[picture p14: page 1]
