TUM-E21-ThinFilms/BigChamber/Motor/Schematics/05_Schematics/Motor-B_Mask.pdf

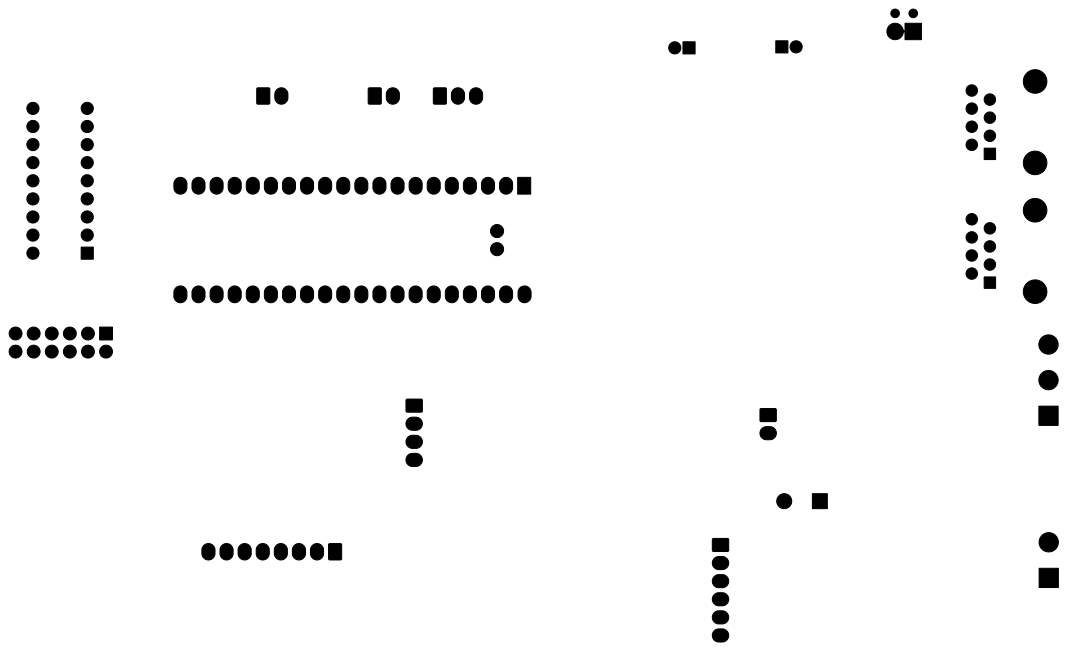
[picture p15: page 1]
