TUM-E21-ThinFilms/BigChamber/Motor/Schematics/05_Schematics/Motor-Edge_Cuts.pdf

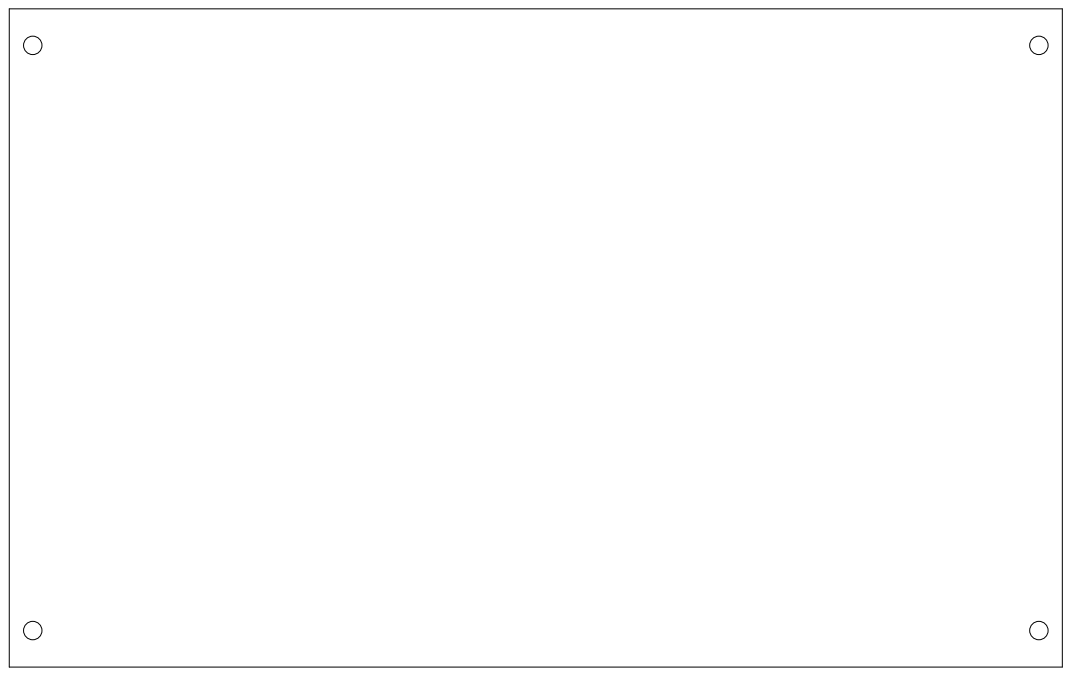
[picture p16: page 1]
