TUM-E21-ThinFilms/BigChamber/Motor/Schematics/05_Schematics/Motor-F_Cu.pdf

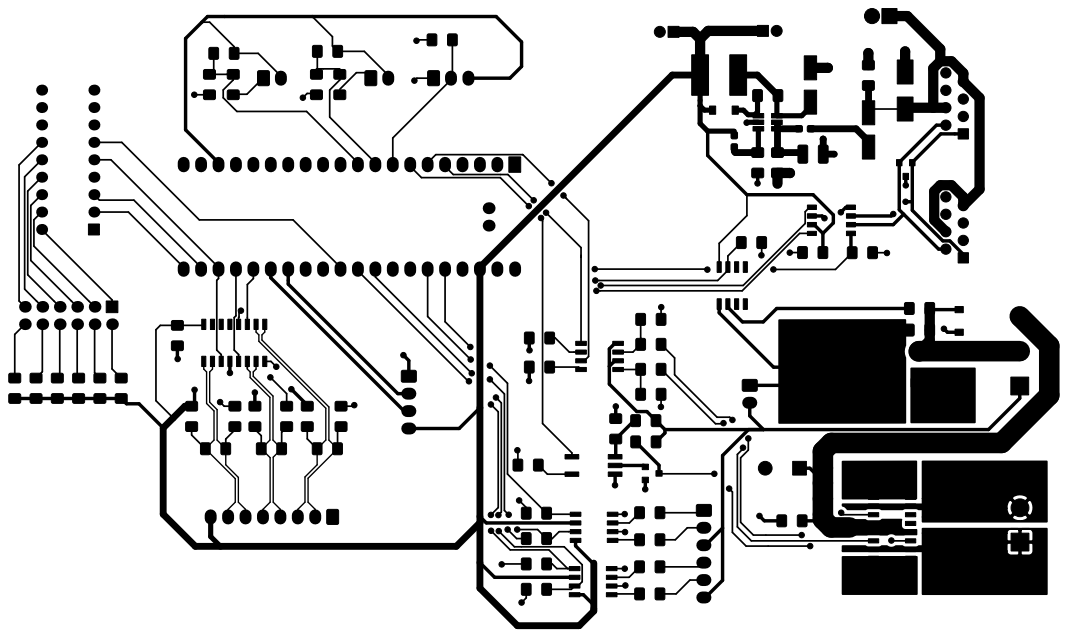
[picture p17: page 1]
