TUM-E21-ThinFilms/BigChamber/Motor/Schematics/05_Schematics/Motor-F_Mask.pdf

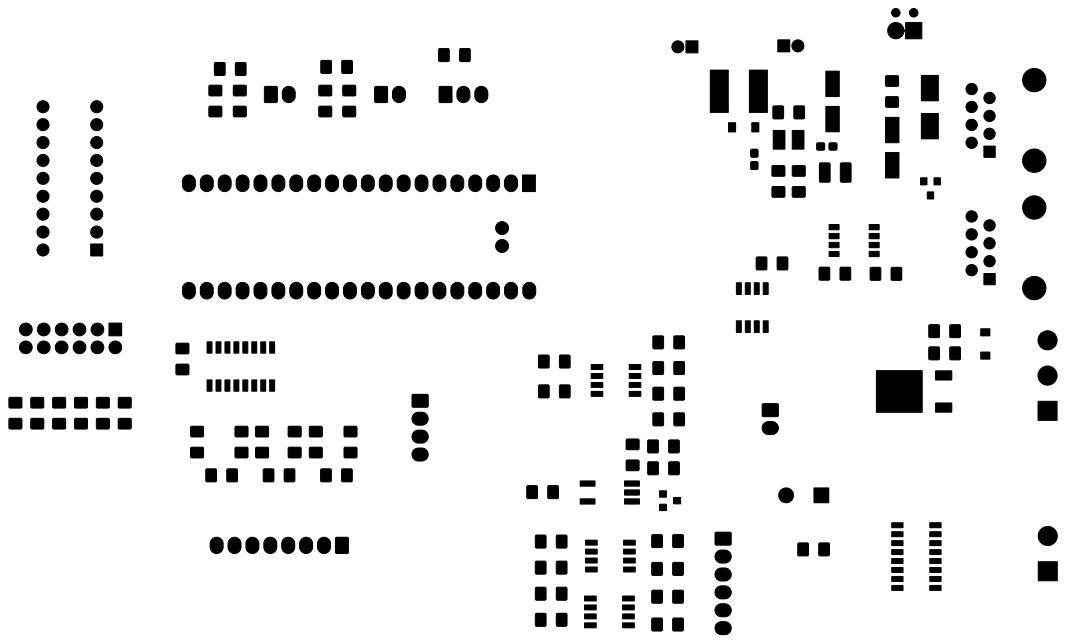
[picture p18: page 1]
