TUM-E21-ThinFilms/BigChamber/Motor/Schematics/05_Schematics/Motor-F_Paste.pdf

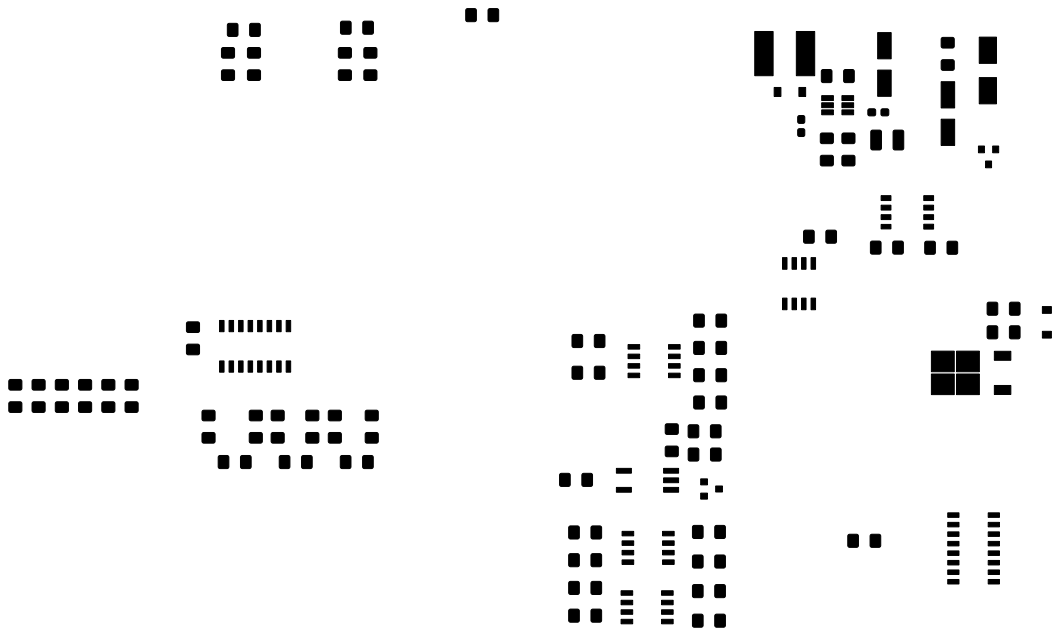
[picture p19: page 1]
