TUM-E21-ThinFilms/BigChamber/Motor/Schematics/05_Schematics/Motor-F_SilkS.pdf

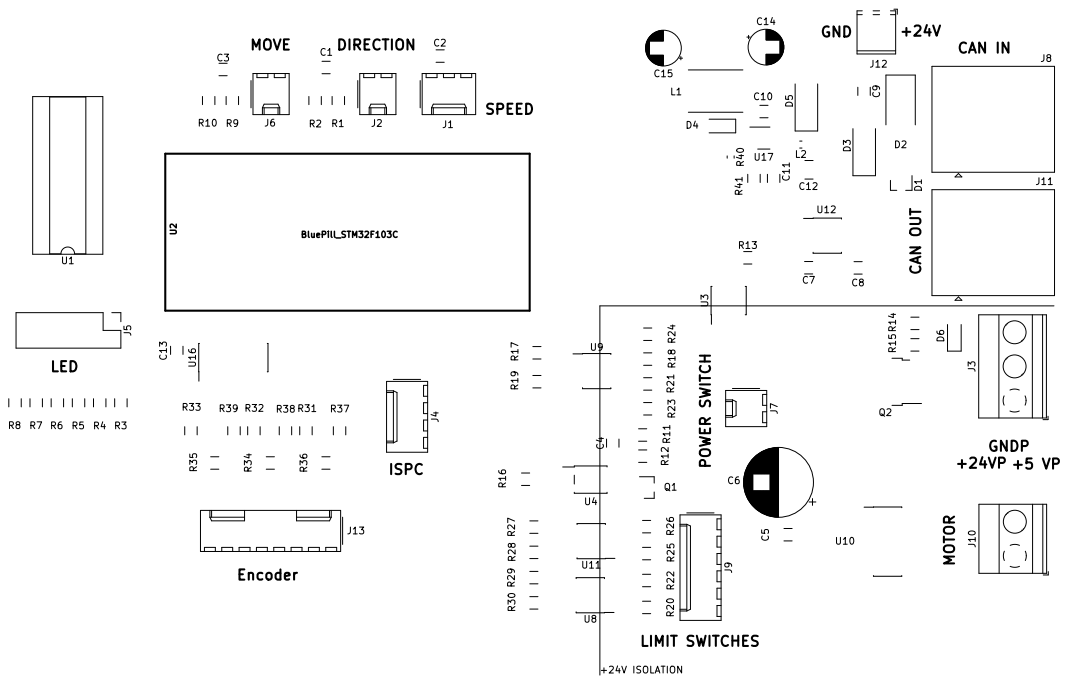
[picture p20: page 1]
