TUM-E21-ThinFilms/BigChamber/Relay/Schematics/05_Schematics/Relay_Controller2-B_Cu.pdf

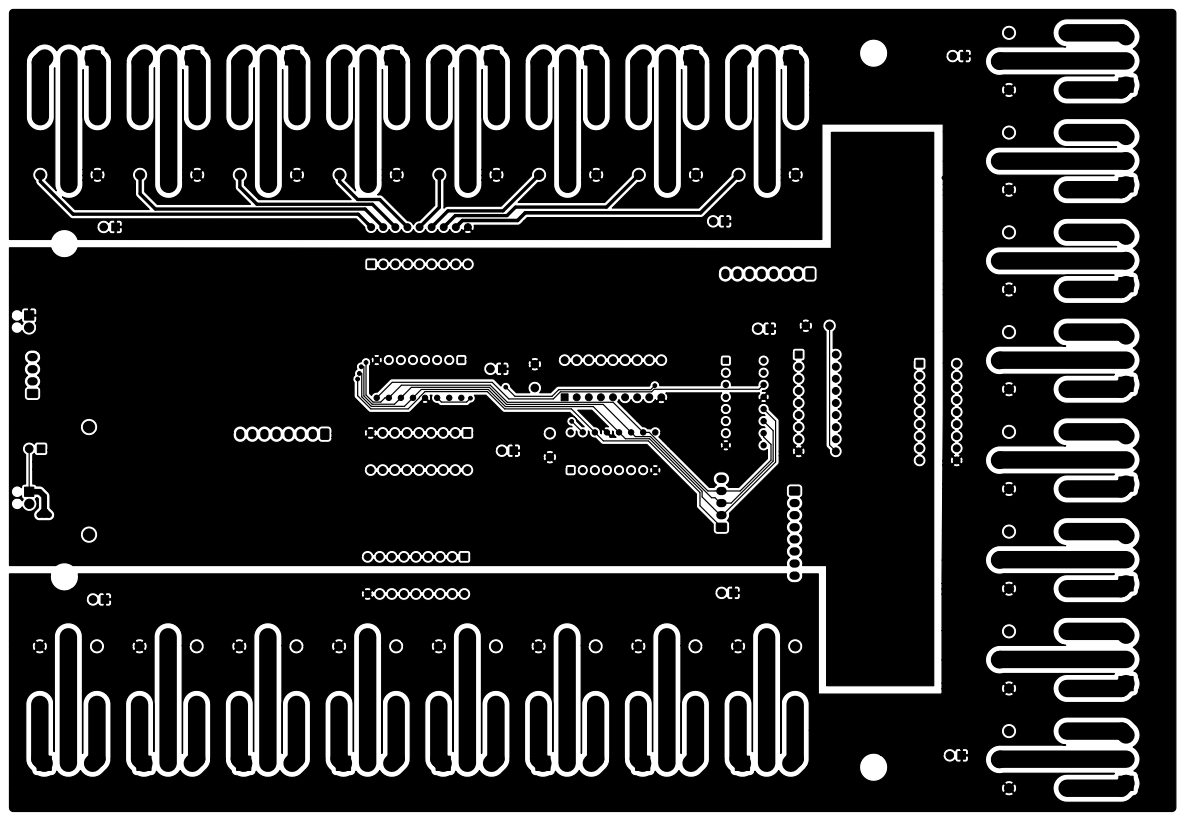
[picture p21: page 1]
