TUM-E21-ThinFilms/BigChamber/Relay/Schematics/05_Schematics/Relay_Controller2-B_Mask.pdf

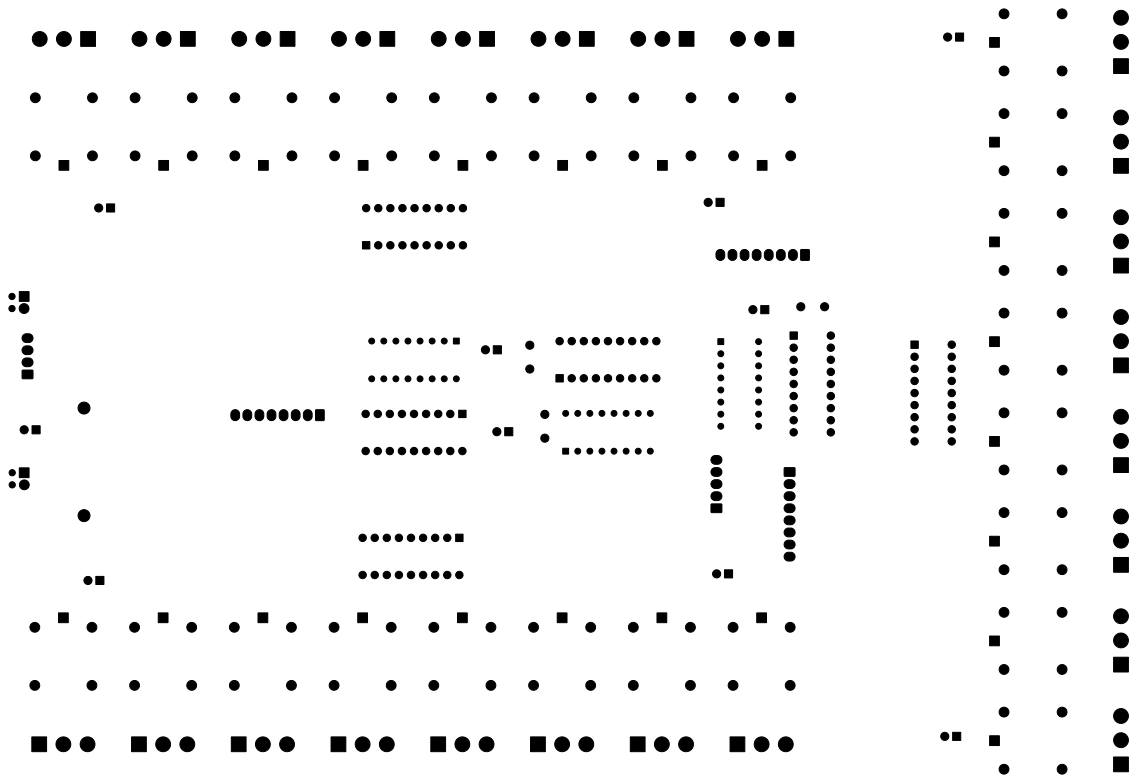
[picture p22: page 1]
