TUM-E21-ThinFilms/BigChamber/Relay/Schematics/05_Schematics/Relay_Controller2-Edge_Cuts.pdf

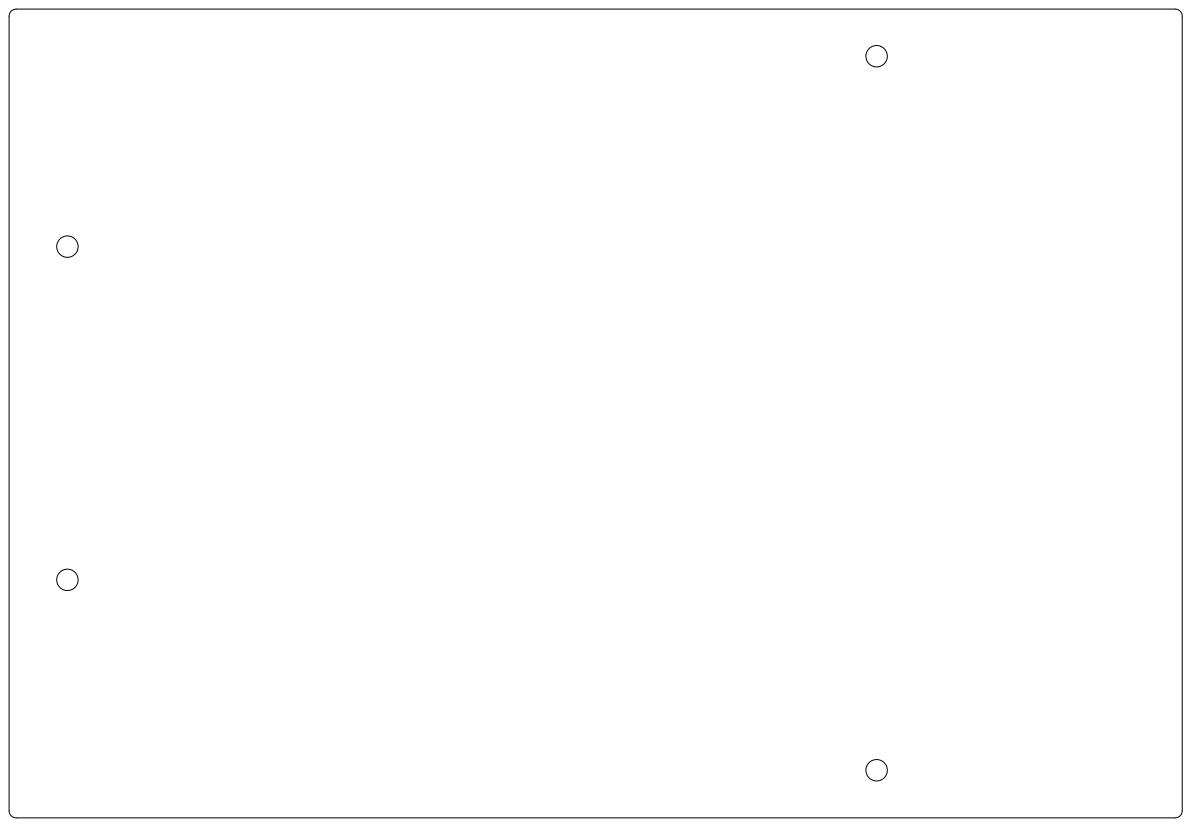
[picture p23: page 1]
