TUM-E21-ThinFilms/BigChamber/Relay/Schematics/05_Schematics/Relay_Controller2-F_Cu.pdf

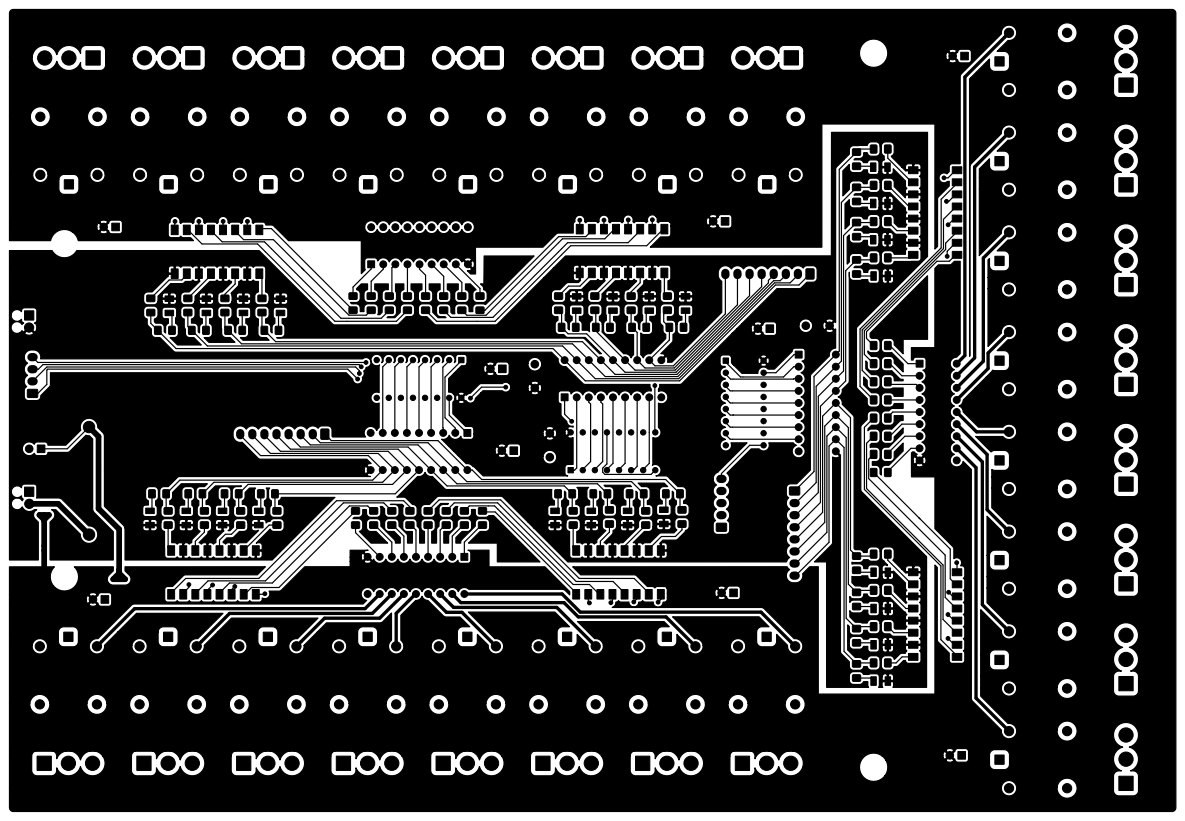
[picture p24: page 1]
