TUM-E21-ThinFilms/BigChamber/Relay/Schematics/05_Schematics/Relay_Controller2-F_Mask.pdf

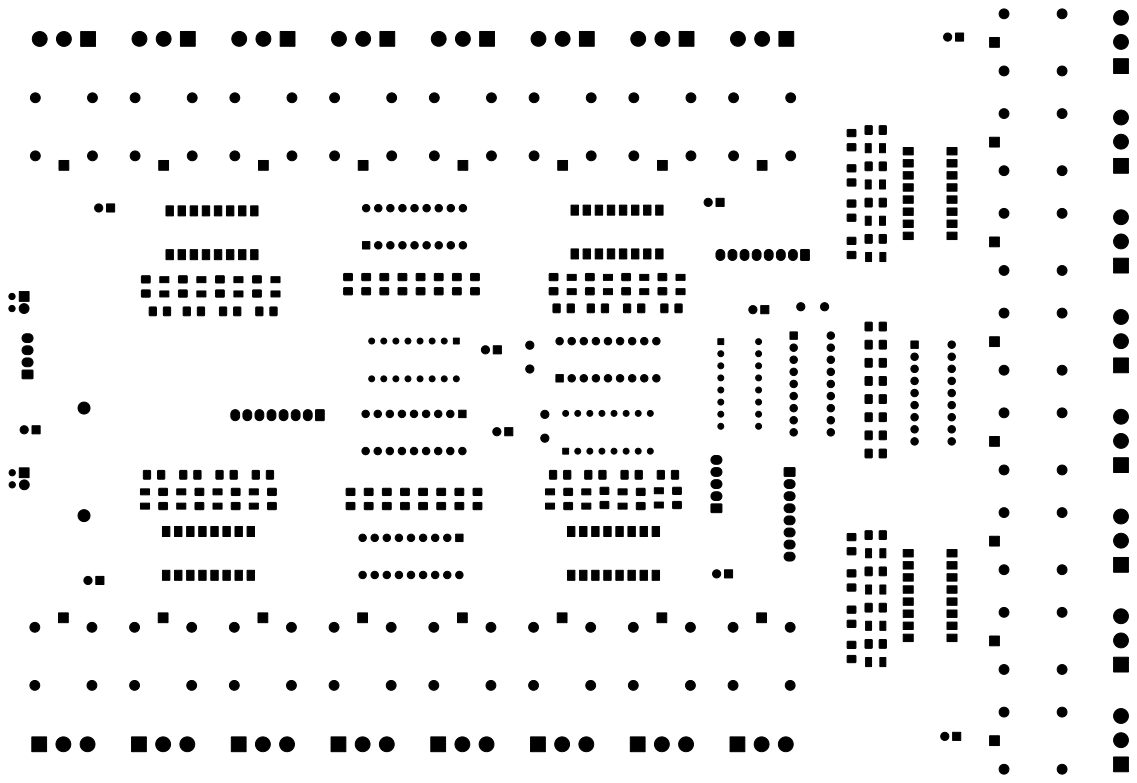
[picture p25: page 1]
