TUM-E21-ThinFilms/BigChamber/Relay/Schematics/05_Schematics/Relay_Controller2-F_Paste.pdf

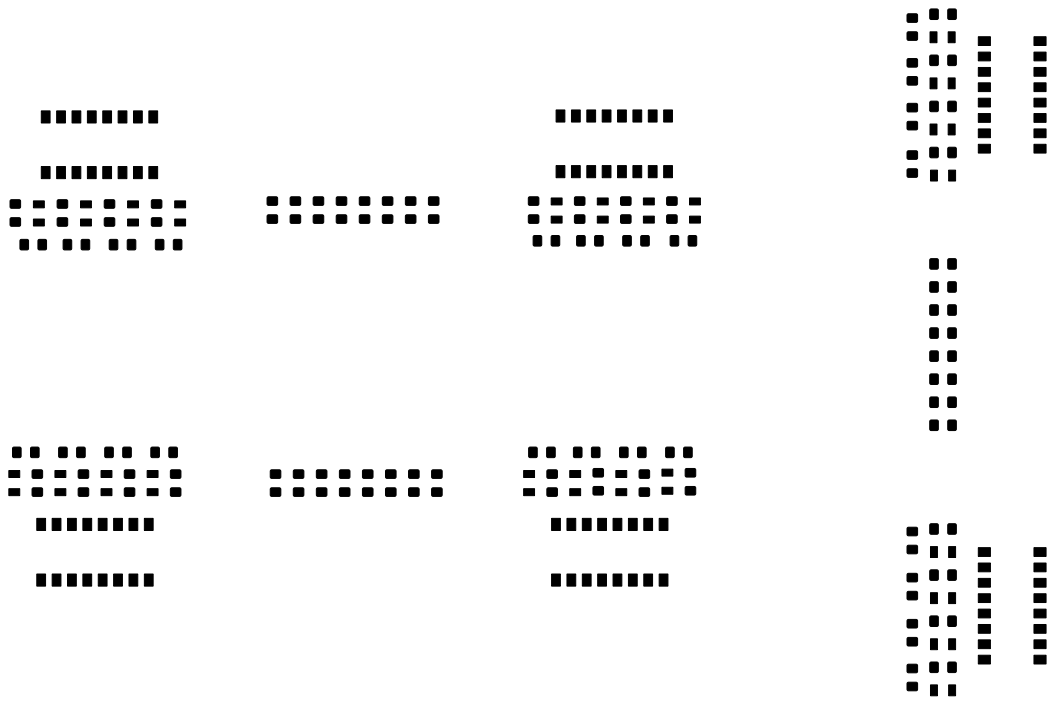
[picture p26: page 1]
