TUM-E21-ThinFilms/BigChamber/(commit log)

2019-07-22 updating structure
    [Motor-B_Cu.gbr, Motor-B_Mask.gbr, Motor-B_Paste.gbr, Motor-B_SilkS.gbr, Motor-Edge_Cuts.gbr, Motor-F_Cu.gbr, Motor-F_Mask.gbr, Motor-F_Paste.gbr]
2019-07-22 adding schematic as pdf
    [Motor.sch]
2019-07-22 updating gerber files
    [Motor-B_Cu.gbr, Motor-B_Mask.gbr, Motor-B_Paste.gbr, Motor-B_SilkS.gbr, Motor-Edge_Cuts.gbr, Motor-F_Cu.gbr, Motor-F_Mask.gbr, Motor-F_Paste.gbr]
2019-07-23 updating connectors
    [Motor-B_Cu.gbr, Motor-B_Mask.gbr, Motor-B_Paste.gbr, Motor-B_SilkS.gbr, Motor-Edge_Cuts.gbr, Motor-F_Cu.gbr, Motor-F_Mask.gbr, Motor-F_Paste.gbr]
2019-07-23 updating LimitSwitch Connector
    [Motor-B_Cu.gbr, Motor-B_Mask.gbr, Motor-B_Paste.gbr, Motor-B_SilkS.gbr, Motor-Edge_Cuts.gbr, Motor-F_Cu.gbr, Motor-F_Mask.gbr, Motor-F_Paste.gbr]
2019-07-24 updating encoder connector
    [Motor-B_Cu.gbr, Motor-B_Mask.gbr, Motor-B_Paste.gbr, Motor-B_SilkS.gbr, Motor-Edge_Cuts.gbr, Motor-F_Cu.gbr, Motor-F_Mask.gbr, Motor-F_Paste.gbr]
2019-07-25 Adding 10A fuse; Adding pictures
    [Motor.kicad_pcb, Motor.sch]
2019-07-25 Adding fuse to BOM
    [Motor.xml]
2019-07-30 adding 3.3v LDO, adding footprints for front panel
    [Motor.kicad_pcb, Motor.sch, Motor.xml, driver_1.sch, frontpanel.sch]
2019-08-16 bugfix: Arduino mega expects a uint8_t * instead of a int * ...
    [Relay_module.ino]
2019-08-16 removing unused pin definitions
2019-09-09 Power Distribution Module
    [PDM.kicad_pcb, PDM.sch]
2019-10-16 adding zones
    [pdm_1-rev0.kicad_pcb]
2019-10-16 Zones filled
    [pdm_1-rev0.kicad_pcb]
2019-10-17 PDM + RC232C Interface
    [RS232C Interface.sch, file PDM.sch, pdm_1-rev0.sch]
2019-11-04 PCB update
    [RS232CInterface.kicad_pcb, RS232CInterface.sch, filePDM.sch]
2019-11-11 PCB updated, Lever Shifter added
    [RS232CInterface.sch, filePDM.sch]
2019-11-11 PCB updated
    [_saved_ControllInterface.sch]
2019-11-11 PCB updated, Level Shifter added
    [RS232CInterface.kicad_pcb]
2019-11-18 Zones and routes updated
    [RS232CInterface.kicad_pcb.kicad_pcb]
2019-11-25 PCB Rev0
    [RS232CInterface.kicad_pcb.kicad_pcb, Rev0.kicad_pcb]
2019-11-25 Gerber Plots
    [RS232CInterface.kicad_pcb-B.Mask.gbr, RS232CInterface.kicad_pcb-B.Paste.gbr, RS232CInterface.kicad_pcb-B.SilkS.gbr, RS232CInterface.kicad_pcb-Bottom.gbr, RS232CInterface.kicad_pcb-Edge.Cuts.gbr, RS232CInterface.kicad_pcb-F.Mask.gbr, RS232CInterface.kicad_pcb-F.Paste.gbr, RS232CInterface.kicad_pcb-F.SilkS.gbr]
2019-12-23 Devices and Lables sheet added
    [DevicesLables.ods]
